xubicheng/advanced-desktop/hardware/README.md

# hardware/ — 外壳、转接板、装配图

```
hardware/
├─ enclosure/        外壳：FreeCAD 参数化模型 + OpenSCAD 备选 + 打印参数
├─ adapter-board/    载板/转接板：KiCad 工程（电源保护 + Hub 供电 + 排针 + 按键）
└─ assembly/         装配图、爆炸图、螺丝与走线表
```

## 状态

- `adapter-board/`：**Carrier-Lite v0.1 草案已出板**（60×45mm，2 层），含 Gerber、BOM、坐标、STEP、预览与制板说明，见 [FAB-NOTES.md](adapter-board/FAB-NOTES.md)。未出原理图，尺寸待实测。
- `enclosure/`、`assembly/`：**仍为空骨架。** 设计参数已定，图纸尚未出。

## 已定的关键参数（照此建模）

| 项 | 值 | 出处 |
|---|---|---|
| 外形 | **132 × 76 × 40 mm** | v3 §3.1 |
| 内部净高 | ≥ 24 mm（RJ45 13.5mm 为最高元件） | v3 §3.1 |
| 主板 | BeagleBone Black，86.36 × 53.34 × 1.6 mm | 官方 |
| 壁厚 | 2.4–3.0 mm | v3 §6.2 |
| 材质 | **ABS**（主体）+ **5052 铝 1.5mm**（底盖兼配重） | v3 §6.2 |
| 开孔率 | 总 3.3–3.6%（侧面进风 φ2×6×2，底部后段出风 φ2×12） | v3 §6.3 |
| 顶面 | **不开孔**（手感 / 进灰 / 烫手） | v3 §6.3 |
| 散热片 | 铝 20×20×8 + 导热垫 1.0mm ≥3W/mK | v3 §6.4 |
| 光学高度 | 按实测的鼠标模块定，配 0.5/1.0/1.5mm 三档垫片 | v3 §4.4 |

## 许可

**CERN-OHL-S-2.0**（强互惠）。改过的设计必须以同一许可公开。
