xubicheng/advanced-desktop/logs/2026-11-06-v1-to-v4.md

# 对话纪要（脱敏）· 2026-11-06 · v1 → v4

> 本文是需求与决策的**留痕**，不含任何凭证、联系方式、账号信息。
> 详细技术判断见 `docs/CHANGELOG.md`。

---

## 第一轮（v1）：可落地的完整设计方案

**需求要点**
- 产品：鼠标形态的无屏微型计算机；板载麦克风与扬声器；无屏；HDMI 外接；自身位移驱动光标；Linux；开源硬件；MIT。
- 明确排除树莓派。
- 元器件需在南京金盛 / 华龙可买。
- **不要实际下单、不要联网采购、不要动任何现有站点。**
- 要求逐条回答 12 个工程问题（主控、显示接口、光标、光学、音频、AI 链路、OS 与授权、供电、BOM、MVP、验收、风险合规）。
- 诚实优先，型号/封装/数量必须具体，不写营销话术。

**产出**：v1 方案（H618 / Orange Pi Zero 3 路线），BOM ≈ ¥320 / 降本 ¥169。

**结论**：路线可行，但板级不开源（只有原理图 PDF，无 Gerber），与「全开源硬件」冲突。

---

## 第二轮（v2）：开源硬件成为硬门槛

**需求要点**
- 「全开源硬件」是硬门槛，成本可高、性能可弱；H618 / Orange Pi 作废。
- 讲清 L0–L3 分层，给 2–3 个真 L1 候选，明确首选与性能代价；做不到 L0 要直说。
- 软件：一套核心 + Linux/Android 双端；Android 息屏可用。
- 逐项许可证清单，不得笼统说「都是 MIT」（点名 FFmpeg 双轨、Android TTS/ASR 闭源、Kotlin/Compose、Flutter）。
- 取消电池，改 USB-C 5V/3A。
- 手工组装友好：2.54 排针 / 凤凰端子 / JST-XH，禁 0.5mm FPC 与 BGA；说明哪些委外、哪些自焊。
- 散热从外壳设计解决，目标满载 30 分钟 ≤45°C，两级后备。
- 光学买芯片 + 透镜配套件；P0 用整块 USB 鼠标模块兜底。
- 线上 / 线下两张采购清单。
- 尝试读取一个飞书参考链接，取不到要如实说明。
- 版本化目录 + CHANGELOG + README。

**产出**：v2 方案（L0–L3、BeaglePlay 首选 / BBB 备选 / Milk-V Mars 判 L1.5）+ MVP 清单 + CHANGELOG + README。

**关键判断**：L1 + 真鼠标形态 + 1080p **只能取二**。
**如实说明**：飞书链接取不到（需登录，返回登录页图片），未采纳、未编造。

---

## 第三轮（v3）：决策闭环

**用户拍板**
- D1 = β BeagleBone Black（L1，720p，单核 1GHz，¥550 级）；
- D2 = 坚持真鼠标形态，不做掌托式；
- D3 = 直接内嵌成品 USB 鼠标模块，不做 PMW3389 自研（光学腔问题消失）；
- D4 = 先 Android，再 Linux 硬件端，但目标平台要覆盖 Windows 10+ 与 Linux；
- D5 = 严格宽松许可（只允许 Apache/MIT/BSD），**不把 GPL 库链接进核心，允许 GPL 工具以独立进程 / CLI 调用**。

**其他要求**
- 逐条算清 β 的六项工程连带代价（外壳尺寸、USB Hub、720p、单核性能、micro-HDMI 与供电、断供降级链），不许回避。
- 采购淘宝优先；线下只买通用件；给总预算。
- 建 public 仓库，三许可分层，先加 `.gitignore` 再首次提交，纪要脱敏。
- 里程碑汇报：Android 最小链路成型先报一次；仓库推送成功立刻报。
- 诚实优先，不得编造型号/价格/供货/性能/许可证。

**产出**：v3 方案 + Android 先行周计划 + 许可清单 + 采购清单 + DECISIONS + CHANGELOG。

**关键结论（都是硬事实）**
- 外壳下限 **132×76×40mm**，重 **250–300g**（常规重鼠的 2 倍）；
- 单核 1GHz 上 whisper tiny 慢 5–10 倍 → **本地 STT/TTS 判死**，只留预录提示音；
- 供电必须 **DC 5V/4A**，峰值 2.76A，入口 ≥4.90V；
- BBB 断供的 L1 降级链：BBB → BBB Wireless → BeagleBone Green → BeaglePlay（破形态）→ 暂停，**不退回专有板**。

---

## 第四轮（v4）：概念模型修正

**用户澄清**（推翻 v3 的理解）
- 不是「AD 要做 Android 版 + Windows 桌面版 + Linux 桌面版」三套软件；
- 而是：**AD 本体的画面要能投到 Windows 10/11 与 Linux 桌面的显示器上**；
- AD 是那台无屏计算机，**显示器是别人的**；手机是 AD 的一种载体，屏幕可以息屏。

**用户给出的三条投屏路线**（要我给取舍而非罗列）
1. 自渲染 + 自有 Receiver（MJPEG over TCP）——倾向做 MVP；
2. scrcpy 路线（Apache-2.0）——做兜底；
3. WebRTC / 硬件 H.264——功能强但有许可与体积问题。

**我的取舍**
- **首选方案 1**：只有它能做到「AD 自己的画面」而不是「镜像整块手机」；只有它在息屏时天然成立；许可全宽松；体积最小；且 AD 的 UI 是状态驱动、帧率需求低，MJPEG 的带宽劣势几乎不存在。
- **方案 2 做兜底**，触发条件写死（需要 >20fps 或要看手机原生界面）。
- **方案 3 留架构位**（三个 trait：FrameSource / FrameEncoder / FrameTransport），给出 4 个升级切换点。

**技术纠偏**
- 用户建议「Android 自带 YuvImage/JPEG 编码」——方向对、API 错：`YuvImage` 吃 NV21，是给相机用的；我们自渲染的产物在 `Bitmap` 里，应该用 `Bitmap.compress(JPEG, q, out)`。

**反向输入**
- USB 鼠标模块（OTG）→ 读 HID 端点 → `PointerEvent` → TCP 上行 → Windows `SendInput` / Linux `/dev/uinput`。
- 与 BBB 端**共用同一份事件结构体**，只是注入后端不同。
- 「AD 当别人的鼠标」这条链路天然成立。

**如实说明的边界**
- Windows 的 UAC 提权窗口、锁屏、安全桌面**收不到 SendInput**——这是系统安全边界，不是 bug；
- Linux 的 `/dev/uinput` 需要 `input` 组或 udev 规则，**不是开箱即用**；
- Android 的 USB 设备授权每次插拔可能弹框；
- 息屏后厂商 ROM 可能限流，帧率会掉，需实测。

**产出**：v4 方案（概念模型、投屏三方案取舍、Mermaid 数据流图、反向输入、息屏实测计划 T1–T6、兼容基线、能力差异表、新增风险 7 条）+ CHANGELOG v4.0。

---

## 贯穿四轮的约束（一次都没破）

1. **不下单、不采购、不动任何现有站点**；
2. **诚实优先**：不确定就标「需询价 / 需实测 / 需核实」，不编造型号、价格、许可证；
3. **不为了好看淡化硬事实**（单核跑不动本地模型、鼠标 250–300g、720p 上限）；
4. **参考资料不等于正确**：豆包方案被逐条对照，采纳 4 点、冲突 5 点、错误 5 点。
