xubicheng/advanced-desktop/docs/README.md

# AD 项目文档索引

AD（Advanced Desktop）= **鼠标形态的无屏微型计算机**。板载麦克风与扬声器，语音进、语音出；自身位移驱动光标。**屏幕是可选外设**：要么 BBB 原生 HDMI 直出，要么由 Android 载体把 AD 自己的画面投到 PC 显示器上。硬件走 L1 开源路线（BeagleBone Black），软件是一份 Rust 核心 + 两个渲染器 + 一个 PC 端 Receiver。

> 当前版本：**v4.0**（2026-11-06）
> 状态：决策已闭环（D1–D5），概念模型已修正（AD ≠ 桌面软件）。**未采购、未下单、未改动任何站点。**

---

## 文档清单

| 文档 | 一句话说明 | 版本 | 路径 |
|---|---|---|---|
| **设计方案 v4（当前有效）** | 概念模型修正 + 投屏链路。AD 是本体，屏幕是外设；Windows/Linux 端只是 Receiver（显示帧 + 注入指针） | v4.0 | [v4/AD-鼠标形无屏微型计算机-设计方案-v4.md](./v4/AD-鼠标形无屏微型计算机-设计方案-v4.md) |
| **设计方案 v3（硬件与许可基线）** | β 路线定稿：六项工程连带代价、720p、USB Hub、供电、散热重算、V1–V14 验收、R1–R12 风险。**v4 沿用其 D1/D2/D3/D5、散热、BOM、采购** | v3.0 | [v3/AD-鼠标形无屏微型计算机-设计方案-v3.md](./v3/AD-鼠标形无屏微型计算机-设计方案-v3.md) |
| **Android 先行周计划** | 执行件。2 周排期、W1/W2 共 15 条验收线、代码结构、三族平台兼容基线 | v3.0 | [v3/Android-先行-周计划.md](./v3/Android-先行-周计划.md) |
| **许可清单** | 组件 / 版本 / 许可证 / 是否链接进核心 / GPL 隔离方式 / 风险等级；含模型权重逐项核实状态 | v3.0 | [v3/许可清单.md](./v3/许可清单.md) |
| **采购清单（淘宝优先）** | 表 A 淘宝（关键路径 / 可延后，含搜索关键词）、表 B 线下金盛/华龙、总预算三档 | v3.0 | [v3/采购清单-淘宝优先.md](./v3/采购清单-淘宝优先.md) |
| **决策记录** | D1–D5 已拍板项 + C1 平台范围澄清 + O1–O6 未关闭项 + 历史失效决策 | v3.0 | [DECISIONS.md](./DECISIONS.md) |
| **变更记录** | v1→v2→v3 全部变更，按「变更点 / 原因 / 影响」三列；v3 含参考材料对照（采纳/冲突/错误） | v3.0 | [CHANGELOG.md](./CHANGELOG.md) |
| **MVP 手工样品实施清单** | 执行件。买料、S0–S10 分步装配、每步可测通过标准、上电检查、故障排查 | v2.1（β 路线） | [MVP-checklist/MVP-手工样品实施清单.md](./MVP-checklist/MVP-手工样品实施清单.md) |
| 设计方案 v2（已被 v3 取代） | BeaglePlay 首选 + 掌托式 + 自研光学。保留供追溯 | v2.0 | [v2/AD-鼠标形无屏微型计算机-设计方案-v2.md](./v2/AD-鼠标形无屏微型计算机-设计方案-v2.md) |
| 设计方案 v1（已作废） | H618 路线，板级不开源，保留不删 | v1.0 | [v1/AD-鼠标形无屏微型计算机-设计方案-v1.md](./v1/AD-鼠标形无屏微型计算机-设计方案-v1.md) |

---

## 快速导航

| 你想知道 | 去看 |
|---|---|
| **AD 到底是什么**（是不是要做三套软件） | **v4 §1 概念模型**（答案：不是。AD 是本体，屏幕是外设） |
| 投屏用哪个方案、为什么不用 scrcpy | v4 §2（三方案对比 + 取舍 + 升级切换点） |
| 投屏数据怎么流 | v4 §3（Mermaid 图：路 A / 路 B） |
| AD 怎么驱动 PC 的光标 | v4 §4（OTG HID → PointerEvent → SendInput / uinput） |
| 手机息屏还能投吗 | v4 §5（能，且这是首选方案的关键优势）+ T1–T6 实测计划 |
| 支持 Windows/Linux 哪些版本 | v4 §6（Win10 1809+；glibc ≥2.28；**不支持 CentOS 7/8**） |
| 这东西到底能不能做、要妥协什么 | v3 §0 一句话结论 + §3 六项连带代价 |
| 为什么选 BBB，为什么只有 720p | v3 §3.3 + [DECISIONS.md](./DECISIONS.md) D1 |
| 外壳多大、多重、怎么握 | v3 §3.1（132×76×40mm，250–300g，掌心抓握） |
| USB 三件怎么共存、会不会烧板 | v3 §3.2（自供电 Hub + 切断上游 VBUS） |
| 单核能不能跑本地语音 | v3 §3.4（**不能**，已判死） |
| BBB 买不到怎么办 | v3 §3.6（T0–T4 降级链，不退回专有板） |
| 散热会不会烫手 | v3 §6（ABS + 侧进底出 + 锁频 800MHz） |
| 买什么、多少钱 | [v3/采购清单-淘宝优先.md](./v3/采购清单-淘宝优先.md) |
| 许可证有没有坑 | [v3/许可清单.md](./v3/许可清单.md)（重点看 piper→espeak-ng 与模型权重） |
| 排期 | [v3/Android-先行-周计划.md](./v3/Android-先行-周计划.md) + v4 §8（W3 投屏 / W4 反向指针） |
| 之前为什么推翻 H618 / BeaglePlay / 三套软件 | [CHANGELOG.md](./CHANGELOG.md) 的「已推翻」表 |

---

## 版本规则

1. **不覆盖旧版本**：每次大改新建目录（v4…），旧版原样保留。
2. **每次改动必须进 CHANGELOG**：按「变更点 / 原因 / 影响」三列，不接受无记录的修改。
3. **改设计前先改 DECISIONS**：决策记录是上游，设计文档是下游。
4. **不确定项一律标注**：`【实测】` `【询价】` `【需核实】`，禁止估造。

---

## 目录结构

```
docs/
├─ README.md                                   ← 本文件（索引）
├─ CHANGELOG.md                                ← 变更记录
├─ DECISIONS.md                                ← 决策记录（D1–D5 / C1 / O1–O6）
├─ v1/
│  └─ AD-鼠标形无屏微型计算机-设计方案-v1.md      ← 已作废，存档
├─ v2/
│  └─ AD-鼠标形无屏微型计算机-设计方案-v2.md      ← 已被 v3 取代，存档
├─ v3/
│  ├─ AD-鼠标形无屏微型计算机-设计方案-v3.md      ← 硬件与许可基线（部分被 v4 取代）
│  ├─ Android-先行-周计划.md
│  ├─ 许可清单.md
│  └─ 采购清单-淘宝优先.md
├─ v4/
│  └─ AD-鼠标形无屏微型计算机-设计方案-v4.md      ← 当前有效（投屏链路）
└─ MVP-checklist/
   └─ MVP-手工样品实施清单.md                    ← 执行件
```

---

## 外部参考

| 来源 | 状态 |
|---|---|
| `https://feishu.doubao.com/drive/file/DJfTbpN2Doubgvx4VfTctA9snmg`（v2 阶段用户提供） | ❌ **取不到**（需登录，返回登录页）。未采纳其内容，未编造 |
| `D:\原有的下载2026.2\AD设计方案_v2.md`（v3 阶段用户提供的本地文件，豆包生成） | ✅ 已读取 163 行，逐条对照见 [CHANGELOG v3.0 §3.2](./CHANGELOG.md)。采纳 4 点、冲突 5 点、错误 5 点 |
| BeagleBone Black 官方文档 `beagleboard.org/board/beaglebone-black` | ✅ 已核实（尺寸 86.36×53.34mm、AM3358、512MB、micro-HDMI、1×USB-A host） |
| BeaglePlay 官方文档 `docs.beagleboard.org` | ✅ 已核实（v2 阶段） |
| Milk-V Mars 官方文档 `milkv.io` | ✅ 已核实（v2 阶段，判 L1.5） |
| 许可核实：sherpa-onnx / SenseVoice / whisper.cpp / FunASR / VITS / piper / espeak-ng | ✅ 2026-11-06 抓取 LICENSE 原文，详见 [许可清单](./v3/许可清单.md) |
