xubicheng/advanced-desktop/hardware/adapter-board/preview-bottom.png

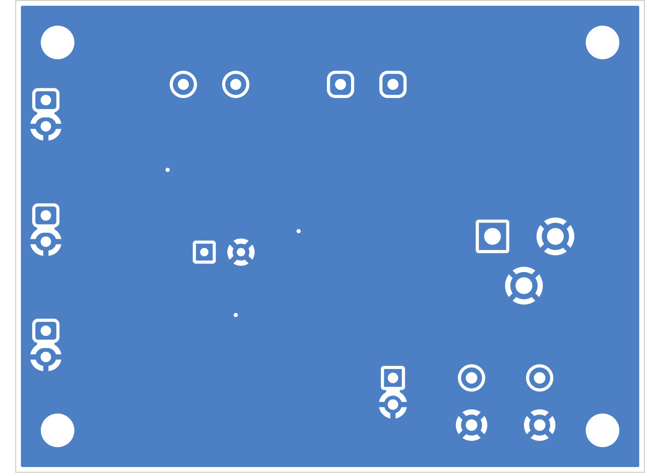
hardware/adapter-board/preview-bottom.png
