xubicheng/advanced-desktop/hardware/adapter-board/preview-top.png

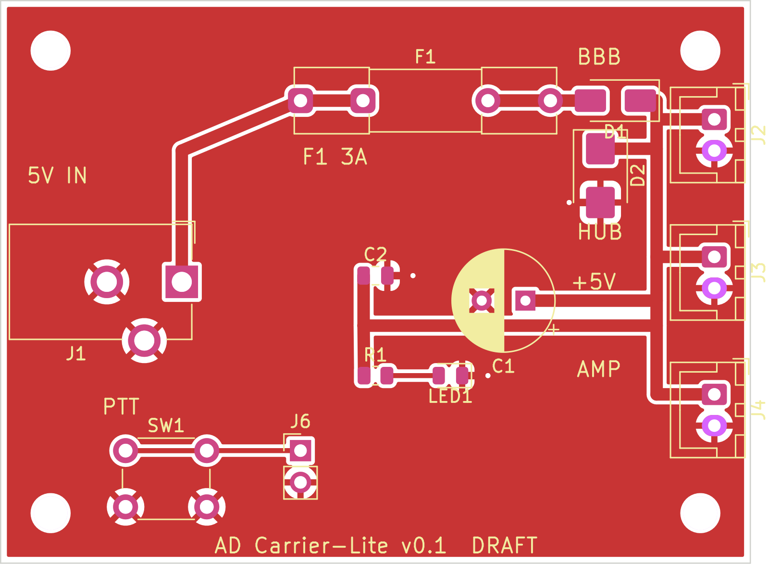
hardware/adapter-board/preview-top.png
