xubicheng/advanced-desktop/bom/README.md

# bom/ — 采购清单

| 文件 | 内容 |
|---|---|
| [BOM-taobao.csv](BOM-taobao.csv) | 表 A：淘宝采购单（关键路径 / 可延后 / 工具 / 耗材） |
| [BOM-offline.csv](BOM-offline.csv) | 表 B：南京金盛 / 华龙线下采购单（含摊位类型） |

## 预算档位

| 口径 | 金额 |
|---|---|
| 最低可行（全自打印、工具已有） | **≈ ¥690** |
| 典型（工具全买、外发打印） | **≈ ¥1,600** |
| 舒适（含全部可选与备用件） | **≈ ¥2,100** |

## 说明

- 所有价格为**区间估算**，不是报价；标注「需询价」的品类波动大；
- **未下单、未询价、未访问任何购物站点**；
- 不提供店铺链接（易失效，且不做背书）；
- 详细理由与避坑见 [docs/v3/采购清单-淘宝优先.md](../docs/v3/采购清单-淘宝优先.md)。
