xubicheng/advanced-desktop/docs/MVP-checklist/MVP-手工样品实施清单.md

# AD MVP 手工样品 · 实施清单

> 配套文档：`docs/v3/AD-鼠标形无屏微型计算机-设计方案-v3.md`（v3.0）
> 适用路线：**β = BeagleBone Black（唯一路线）**。α/γ 已作废。
> 本清单是"照着做"的执行件：**买料 → 焊 → 装 → 测 → 过**。每一步都有可测量的通过标准。
> 状态：**未采购、未下单**。所有价格为区间【询价】，所有性能为预期值【实测】。
>
> **v3 关键差异（照做前必读）：**
> 1. 分辨率 **720p**（不是 1080p）；
> 2. 供电 **DC 5.5×2.1 / 5V 4A**（不是 USB-C 5V/3A）；
> 3. 光标 **只用成品 USB 鼠标模块**，**取消 PMW3389 自研**（原 S5 整节删除）；
> 4. 外壳 **132×76×40mm 真鼠标**（不是 160×95×100 掌托式）；
> 5. 新增 **4 口自供电 USB Hub + 上游 VBUS 断路**；
> 6. 本地 STT/TTS **不做**，语音默认走云端。

---

## 0. 总览

| 阶段 | 内容 | 预计工时 | 卡点 |
|---|---|---|---|
| S0 | 备料与工具 | 2h | 等到货、**BBB 供货** |
| S1 | 裸板点亮（micro-HDMI @720p） | 4h | **不过则换板，不恋战** |
| S2 | 网络 + 输入 | 2h | BBB 无板载 WiFi |
| S3 | 音频链路 | 6h | 底噪/啸叫 |
| S4 | 光标（内嵌成品 USB 鼠标模块） | 3h | **光学高度适配** |
| S5 | ~~光标自研（PMW3389）~~ | — | **v3 已删除** |
| S6 | 集成分线（电源保护 + Hub + VBUS 断路） | 8h | 焊接、反灌 |
| S7 | 结构装配（132×76×40） | 10h | 干涉、打印公差 |
| S8 | 热测与散热整改 | 6h | **第二大不确定** |
| S9 | 语音链路（云端） | 10h | 延迟 |
| S10 | 长跑与验收 | 8h | — |
| **合计** | — | **≈59h** | — |

**原则：S1 不过不许往下走；S4 若光学高度无法适配（换 2 个模块仍失败）→ 改为「外置 USB 鼠标过渡」，不得停摆；S8 超标按两级后备整改。**

---

## 1. S0 备料与工具

### 1.1 采购清单（按"关键路径"排序）

#### A. 线上（淘宝/阿里系，先下这几单，等 2–4 天）

| 序 | 名称 | 型号/规格 | 数量 | 单价区间 | 关键路径 | 备注/替代 |
|---|---|---|---|---|---|---|
| A1 | 主控板 | **BeagleBone Black Rev C**（AM3358/512MB/4GB eMMC） | 1 | ¥400–520【询价】 | ★★★ | 买不到 → BBB Wireless（T1）；再不行看 v3 §3.6 |
| A2 | 光标模块 | **成品 USB 鼠标模块 + 光学透镜**（非 PMW3389 自研） | 2 | ¥25–60 | ★★★ | **买两个不同型号**；不要买成无线接收器 |
| A3 | USB 声卡模块 | CM108 / SSS1629（**mic in** + 3.5mm out） | 2 | ¥15–35 | ★★★ | 必须带麦克风输入 |
| A4 | USB Hub 模块 | 4 口 USB2.0，**自供电、带 5V 外供焊盘** | 1 | ¥15–30 | ★★★ | FE1.1s；GL850G 备选 |
| A5 | USB WiFi | RTL8188EU / 8192EU，**带外置天线** | 1 | ¥20–40 | ★★★ | BBB 无板载 WiFi |
| A6 | micro-SD（可选） | 32GB A1（SanDisk） | 1 | ¥20 | ★ | BBB 可从 eMMC 启动，SD 作救砖 |
| A7 | 散热片 | 铝 20×20×8 | 2 | ¥2–5 | ★ | 壳内空间紧，不要超过 8mm |
| A8 | 导热垫 | 1.0mm，≥3W/mK | 2 | ¥5–15 | ★ | 另备 0.5mm |
| A9 | 杜邦线 / XH2.54 | 20cm 套装 | 1 套 | ¥10–20 | ★ | — |
| A10 | 铜柱螺丝 | M2.5 套装 | 1 套 | ¥15–25 | ★ | **下单前量 BBB 安装孔** |
| A11 | **micro-HDMI 转接** | micro-HDMI 公 → HDMI 母 **软排线** 20cm | 1 | ¥20–40 | ★★★ | **不要硬转接头**（会拽掉座子） |
| A12 | 铝板 | 5052，1.5mm，150×200 | 1 | ¥20–40 | 否 | 底盖兼配重 |
| A13 | 5V 电源 | **5V/4A**，DC 5.5×2.1 | 1 | ¥25–45 | ★★★ | **不能买 5V/3A**；须实测 ≥4.90V |
| A14 | 保险丝 | 3A 慢断 + 5×20 座 | 1 套 | ¥5–10 | ★★★ | **不要用 1.1A 自恢复** |
| A15 | TVS + 肖特基 | SMAJ5.0A ×4，SS54 ×2 | 1 套 | ¥5–8 | ★★ | 过压 + 防反接 |

#### B. 线下（南京金盛 / 华龙电子城）

| 序 | 名称 | 规格 | 数量 | 单价 | 备注 |
|---|---|---|---|---|---|
| B1 | 喇叭 | 40mm 8Ω 2W，带腔体 | 2 | ¥4–12 | 挑两只一致性好的 |
| B2 | 驻极体麦克风模块 | MAX9814 / MAX4466（带 AGC） | 2 | ¥8–20 | 裸驻极体电平太低 |
| B3 | PAM8403 功放板 | 3W，带滤波 | 2 | ¥5–10 | 成品板 |
| B4 | 轻触开关 | 6×6×5 / 12×12 直插 | 10 | ¥0.2–1 | PTT 用大行程 |
| B5 | 拨动开关 | 2 档 3 脚 | 2 | ¥1–3 | 预留总电源 |
| B6 | 洞洞板 | 5×7cm、7×9cm | 各 2 | ¥3–6 | — |
| B7 | 排针/排母 | 2.54 单排 | 各 5 | ¥0.5 | — |
| B8 | JST-XH 端子 | 2P/3P/4P 带线 | 各 5 | ¥1 | 比杜邦线牢 |
| B9 | 电源适配器 | **5V/4A，DC 5.5×2.1** | 2 | ¥30–50 | **现场要求实测输出电压** |
| B10 | DC 座/插头 | 5.5×2.1 | 各 2 | ¥1–5 | — |
| B11 | 电解电容 | 470µF/10V 低 ESR | 5 | ¥0.5 | 电源入口储能 |
| B12 | 磁珠 | 600Ω@100MHz 3A | 5 | ¥0.3 | — |
| B13 | 电阻电容套装 | 0805 常用值 | 1 套 | ¥15 | — |
| B14 | 热缩管/双面胶/扎带 | — | 1 套 | ¥15 | 绝缘固定 |
| B15 | 螺丝/脚贴 | M2.5 + PTFE 脚贴 | 1 套 | ¥15 | 脚贴影响光学高度 |
| B16 | 防尘网 | 80 目尼龙网 | 1 | ¥5–10 | 侧进风口 |

#### C. 工具（若无则补）

| 工具 | 规格 | 必需度 |
|---|---|---|
| 恒温焊台 | 60W，可调 300–350°C | ★★★ |
| 焊锡 | 0.6mm 有铅/无铅 + 助焊剂 | ★★★ |
| 数字万用表 | 带通断/二极管档 | ★★★ |
| USB 电压电流表 | 支持 PD 诱骗更好 | ★★★ |
| 红外测温枪 | −50~380°C | ★★ |
| 游标卡尺 | 0.02mm | ★★ |
| 塞尺 | 0.05–1.0mm | ★★（光学高度） |
| 剥线钳/斜口钳/镊子 | — | ★★ |
| 3D 打印机或外协 | **ABS**（不要 PETG/PLA） | ★★ |

> **★★★ = 缺一件就开不了工。**

### 1.2 到货验收

| 检查 | 方法 | 通过标准 |
|---|---|---|
| 主控板外观 | 目视 | 无磕碰、屏蔽罩无变形、连接器无歪 |
| 主板短路 | 万用表二极管档量 5V↔GND | >1kΩ（<10Ω 立即退货） |
| microSD | 读卡器测容量/速度 | 实测 ≥标称 90% |
| 鼠标模块 | 插电脑当鼠标用 | 光标能动、左右键正常、无丢帧 |
| 声卡模块 | 插电脑听回放 | 无爆音、麦克风能录 |
| 喇叭 | 万用表量阻抗 | 6.5–8.5Ω |

---

## 2. S1 裸板点亮（4h）—— **全项目生死线**

| 步 | 操作 | 工时 | 通过标准 |
|---|---|---|---|
| S1.1 | 下载 **BeagleBoard 官方 Debian 镜像**，用 balenaEtcher 烧到 microSD（或直接烧 eMMC） | 0.5h | 烧写完成无报错 |
| S1.2 | 只接：**DC 5.5×2.1 5V/4A 电源** + **micro-HDMI 软排线 → 显示器** + SD 卡 | 0.5h | 板载 4 个用户灯按官方启动序列闪烁 |
| S1.3 | 用 USB-TTL 接调试串口（P9 的 UART0：GND/TX/RX），看启动日志 | 1.0h | 串口能打印到 `login:` |
| S1.4 | 等待首次启动（1–3 分钟） | 0.5h | **屏幕出现桌面 / 或串口可登录** |
| S1.5 | 设分辨率 1280×720（`xrandr --output HDMI-1 --mode 1280x720` 或 `wlr-randr`） | 0.5h | 显示 1280x720 |
| S1.6 | 连续播放 720p 视频 30 分钟 | 1.0h | **无闪屏、无花屏、无重启、无欠压告警**（`dmesg` 中查 voltage 关键字） |

**判定与止损：**
- ✅ 通过 → 进 S2。
- ❌ 无显示 → 先分三步排查：① 串口有没有启动日志（有 = 板活着，是显示问题）；② 换 micro-HDMI 转接、换显示器；③ 换镜像。3 次仍失败 → **换板**，不要试图改内核。
- ❌ 反复重启 → **90% 是电源**：先量 DC 座入口电压（≥4.90V），再查线径（≤1m、≥20AWG），最后才怀疑板。
- ❌ 串口全无输出 → 检查 USB-TTL 的 TX/RX 是否交叉、GND 是否共地。

> BBB 的 micro-HDMI 座是贴片焊，**插拔时务必扶住板子**；建议转接线一次插好就不再动。

---

## 3. S2 网络 + 输入（2h）

| 步 | 操作 | 工时 | 通过标准 |
|---|---|---|---|
| S2.1 | 先接网线（RJ45）确认联网，再插 USB WiFi 模块 | 0.5h | `ping 223.5.5.5` 通；`iwconfig` 能看到 wlan0 |
| S2.2 | 配 WiFi（`nmcli` 或 `wpa_supplicant`） | 0.5h | 拔掉网线后仍能上网 |
| S2.3 | `apt update && apt upgrade` | 0.5h | 无错误 |
| S2.4 | 插 USB 键盘 + 鼠标，开 SSH | 0.5h | 另一台电脑可 `ssh debian@<ip>` 登录 |

> BBB 无板载 WiFi。**USB WiFi 的天线必须能引出到外壳外部**，否则装在壳里信号会掉一档。

---

## 4. S3 音频链路（6h）

| 步 | 操作 | 工时 | 通过标准 |
|---|---|---|---|
| S3.1 | USB 声卡插上，`arecord -l` / `aplay -l` 能看到设备 | 0.5h | 列出 card/device |
| S3.2 | 麦克风焊到声卡 mic 输入（屏蔽线，<3cm） | 1.5h | `arecord -f S16_LE -r 16000 -c 1 t.wav` 能录到声音 |
| S3.3 | `aplay` 回放录音 | 0.5h | 清晰人声，无爆音/电流声 |
| S3.4 | PAM8403 + 喇叭接线，独立 5V 供电 | 1.0h | 播放音乐有声 |
| S3.5 | 最大音量测响度 | 1.0h | 0.3m 处 **≥75dB SPL**，无破音 |
| S3.6 | 麦克风 + 喇叭同处一盒，测啸叫 | 1.0h | 最大音量**无自激** |
| S3.7 | 底噪测量 | 0.5h | 静音录 10s，RMS **<−60dBFS** |

**常见问题：**
| 现象 | 原因 | 处理 |
|---|---|---|
| 录音全是电流声 | 麦克风线太长/无屏蔽 | 换屏蔽线，缩短到 3cm |
| 音量一大就破音 | 喇叭后腔没做/功放增益过高 | 先做临时后腔（纸盒密封），增益调到 70% |
| 说话时喇叭啸叫 | 麦克风与喇叭同腔 | 物理隔开，麦克风朝上、喇叭朝下 |
| `arecord` 录到静音 | mic bias 未开/接错脚 | 用声卡模块自带的 mic 输入，不要接 line-in |

---

## 5. S4 光标：内嵌成品 USB 鼠标模块（3h）

> v3 的 D3 决策：**不再自研 PMW3389 + 透镜 + 光学腔**。直接买成品 USB 鼠标模块（USB HID），插上就是鼠标。
> 原来的 S5「光标自研」整节删除；不确定性从「写驱动 + 调光学腔」变成「选模块 + 配光学高度」。

| 步 | 操作 | 工时 | 通过标准 |
|---|---|---|---|
| S4.1 | 模块插电脑验证 | 0.5h | 光标能动、左右键/滚轮正常、无丢帧 |
| S4.2 | 模块插 BBB 的 USB 口（此时还没接 Hub） | 0.5h | `lsusb` 能看到；`cat /dev/input/mouse0` 有输出 |
| S4.3 | 量 **透镜下沿到桌面的距离** | 0.5h | 记录实测值（不同模块 1.2–2.0mm 不等）【实测】 |
| S4.4 | 用 3D 打印的三种厚度垫片（0.5 / 1.0 / 1.5mm）试装，找到光标最稳的一档 | 1.0h | 慢移不飘、快移不丢、静止不漂 |
| S4.5 | 用 `xinput` 调加速度与速度（若 DPI 偏高） | 0.5h | 1080p 屏幕上从左上到右下约 3–4 次滑动 |

**熔断规则：**
> 若换 2 个不同型号的模块仍无法让光标稳定移动（飘 / 丢帧 / 完全不响应）→ **不要继续折腾**，改为「外置 USB 鼠标」过渡，把内嵌留到结构版再解决。项目不得因此停摆。

**常见问题：**
| 现象 | 原因 | 处理 |
|---|---|---|
| 光标完全不动 | 模块光学高度太高（透镜离桌面太远） | 减薄垫片，让透镜贴近桌面 |
| 慢移正常快移飘 | 光学高度偏低 / 桌面太光滑 | 加 0.5mm 垫片；换鼠标垫测试 |
| 静止时缓慢漂移 | 桌面反光 / 漏光 | 换哑光鼠标垫；模块四周遮光 |
| 光标「飞」得太快 | DPI 过高（1600+） | 用 `xinput --set-prop` 降加速度，或换 800/1000 DPI 模块 |
| 左右键没反应 | 买成了「只有传感器没有按键」的模块 | 换带完整按键的模块 |

---

## 6. S5（已删除）

原 S5「光标自研（PMW3389 + 光学腔）」在 v3 中被 D3 决策取消，**整节作废**。留此标题只为让旧版读者知道「这里少了一节」，不是遗漏。

---

## 7. S6 集成分线（8h，可选但推荐）

> 目的：把「DC 输入保护 + USB Hub 自供电路 + 排针 + 按键」做在一块洞洞板上，替代一堆飞线。
> 元件数控制 **≤25 个**，全部 0805/插件，纯手焊。

| 步 | 操作 | 工时 | 通过标准 |
|---|---|---|---|
| S6.1 | 洞洞板布局（先画纸上草图） | 1.0h | 元件不重叠，走线最短；**Hub 远离麦克风** |
| S6.2 | 焊 DC 5.5×2.1 座 → 3A 保险丝 → SS54（防反接）→ SMAJ5.0A → 470µF + 100nF | 2.0h | 空载输出 5.0±0.1V；**反接测试不烧**（用限流电源试） |
| S6.3 | 焊 Hub 的 5V 外供线（从系统 5V 母线取） | 1.0h | Hub 4 口供电正常，单口带载 0.5A 不掉压 |
| S6.4 | **切断 Hub 上游线的 VBUS（红线）与 ID，只留 D+/D−/GND**，断口热缩绝缘 | 1.0h | 万用表量上游 VBUS 与 Hub 5V **不导通**（>1MΩ） |
| S6.5 | 焊排针引出 5V / GND / PTT GPIO（P9 的 GPIO 口） | 1.0h | 万用表通断全通 |
| S6.6 | 焊 PTT 轻触 + 音量键 + 指示灯（各串 1kΩ 限流） | 1.0h | 按下导通、松开断开 |
| S6.7 | **上电前检查**：5V↔GND | 0.5h | **>1kΩ** |
| S6.8 | 反灌验证（V5 验收） | 0.5h | 只给 Hub 供电、不给 BBB 供电时，BBB **不得出现半上电**（指示灯不亮、串口无输出） |

### 上电检查点（每次通电前必做，5 步）

1. **目视**：无连锡、无歪件、无金属屑；
2. **通断**：二极管档量 5V↔GND，**>1kΩ**；
3. **极性**：电解电容负极、二极管方向、**DC 座中心正**；
4. **限流上电**：可调电源限流 500mA，看电流是否异常（>300mA 空载即有短路）；
5. **全电流上电**：确认正常后接主板。

---

## 8. S7 结构装配（10h）

| 步 | 操作 | 工时 | 通过标准 |
|---|---|---|---|
| S7.1 | 泡沫/纸板做 1:1 内腔模型（**132×76×40**），试装板+Hub+喇叭+散热片 | 2.0h | 全部就位，能盖上；**内部净高 ≥24mm** |
| S7.2 | FreeCAD 参数化建模（长/宽/高/壁厚/接口位置 5 个变量） | 3.0h | 导出 STEP/STL 无破面 |
| S7.3 | 打印（**ABS**，0.2mm 层高，30% 填充，3 壁） | 2.0h | 尺寸误差 ≤0.3mm；**先打半壳试装** |
| S7.4 | 装铜柱、固定主板、贴导热垫 + 20×20×8 散热片 | 1.0h | 主板不晃，散热片贴合 |
| S7.5 | 装喇叭 + 密封音腔（3mm EVA 围边） | 1.0h | 后腔密封（吹气不漏） |
| S7.6 | 装鼠标模块 + **三档垫片校准光学高度** | 0.5h | 光标不飘、不丢帧 |
| S7.7 | 侧进风 / 底出风开孔 + 80 目防尘网 + 尾部接口应力消除 | 1.0h | 总开孔率 3.3–3.6%；孔边倒角 0.5mm 无毛刺 |
| S7.8 | 走线、扎带、绝缘垫、脚贴、称重记录 | 0.5h | 无线材被夹；**实测重量记入验收表** |

**装配顺序（不可颠倒）：**
```
下壳（含铝底板） → 鼠标模块 + 光学垫片 → 喇叭+音腔 → Hub 与电源小板 → 主板+散热片 → 麦克风 → PTT 按键 → 上盖 → 脚贴 → 称重
```

**固定与绝缘规范：**
| 项 | 做法 |
|---|---|
| 承重 | **只能用尼龙柱 + M2.5 螺丝**，热熔胶只做辅助定位 |
| 板底 | 贴 0.5mm 青稞纸/聚酰亚胺胶带 |
| 电源线 | 20AWG 红黑双绞，走边缘，远离麦克风与光学窗 |
| 麦克风线 | 屏蔽线，屏蔽层单端接地 |
| micro-HDMI | 壳内 S 型弯 + 扎带 + 硅胶，做应力释放（**最容易拽掉**） |
| 喇叭 | 四周 1mm EVA 泡棉防共振 |
| 光学窗 | 外侧贴 0.1mm 防尘毛毡圈；**禁用胶水**（会污染透镜） |

---

## 9. S8 热测与整改（6h）

| 步 | 操作 | 工时 | 通过标准 |
|---|---|---|---|
| S8.1 | 25°C 环境，**锁频 800MHz**，满载（`stress-ng --cpu 1 --vm 1` + 循环 TTS + WiFi 传输） | 0.5h | 系统稳定 |
| S8.2 | 30 分钟后红外测温（**顶面手掌区 5 点**、左右侧面、底部出风口） | 0.5h | 取 5 点最高值 |
| S8.3 | 读 `/sys/class/thermal/thermal_zone0/temp` | 0.5h | — |
| S8.4 | 查降频：`cpufreq` 的 `time_in_state` 是否出现 1GHz 档 | 0.5h | **不应出现** |
| S8.5 | 判定 | 0.5h | **顶面 ≤45°C 且 SoC ≤85°C 且不降频** |
| S8.6 | 不达标 → **后备 1**：顶面靠后 1/3 开 20×40mm 细格栅（1.2mm 缝 ×8） | 2.0h | 复测降 5–8°C |
| S8.7 | 仍不达标 → **后备 2**：尾部加 5V 20mm 风扇（吸入式） | 1.5h | 复测降 12–18°C |
| S8.8 | 都不达标 → 后备 3：降频 600MHz + 关 WiFi 改有线 | 0.5h | 复测降 4–6°C，记录性能损失 |

**若三级后备都不达标**：说明「L1 板 + 鼠标形态」在散热上确实到顶，应改为开放式支架或等 T3（BeaglePlay），**不要在壳上无限加风扇**。

**开孔权衡（必须写进验收记录）：**
- 开孔率每 +1%，腔内温度约降 1.5–2.5°C，但进灰速率约 +25%；
- 底部孔会吸桌面灰尘，**约 3 个月需清一次**（拆底盖，软毛刷 + 气吹）；
- 侧面孔位于握持凹陷处，**必须倒角 0.5mm + 内侧贴 80 目网**，否则硌手；
- 顶面**不开格栅**：手掌整面贴合，开孔=手感灾难 + 烫手 + 大量进灰。只有在后备 1 才动，且只开靠后 1/3。

---

## 10. S9 语音链路（10h）—— **默认云端，本地不做识别**

> v3 的硬结论：单核 Cortex-A8 @1GHz 上，whisper tiny 慢 5–10 倍、sherpa-onnx 慢 3–5 倍，**本地 STT/TTS 不可用**。
> 所以本节只做：云端 STT/LLM/TTS + 本地预录提示音 + 规则引擎降级。

| 步 | 操作 | 工时 | 通过标准 |
|---|---|---|---|
| S9.1 | PTT 按键（GPIO，去抖 20ms，长按 200ms 触发）+ 录音门控 | 2.0h | 按住说、松开停；误触发 0 |
| S9.2 | 录音 16k/16bit/mono，opus 20ms 帧编码 | 2.0h | 3 秒录音文件 ≤ 12KB；解码回放无失真 |
| S9.3 | 接云端 STT（HTTPS 上传） | 1.5h | 3 句中文，字准确率 ≥ 90% |
| S9.4 | 接云端 LLM（OpenAI 兼容，SSE 流式）+ 分句缓冲 | 1.5h | 首 token ≤ 1.5s；按句切分 |
| S9.5 | 接云端 TTS（流式）→ USB 声卡 → PAM8403 播放 | 1.5h | 首音 ≤ 3.5s（端到端） |
| S9.6 | 预录提示音 6–10 条（16k WAV）+ 规则引擎（音量/暂停/静音/取消） | 1.0h | 断网时这些指令仍可用 |
| S9.7 | 降级：网络探测 → 超时 5s → 播报「服务慢」→ 断网播报「网络不通」 | 0.5h | 断网 ≤2s 给出语音反馈，**不尝试本地识别** |

> **注意**：不要用 piper —— 它依赖 espeak-ng（GPL-3.0），链接后你的程序整体变 GPL-3.0。本项目 P0 不用本地 TTS，若将来要用，选 sherpa-onnx TTS（Apache-2.0）且需先核实权重许可。

**降级三级（与 v3 方案 §3.4 一致）：**
1. 云端全通 → 正常；
2. 网络通但云服务超时（>5s 无首包）→ 播报「服务慢，先记下」，语音存本地队列；
3. 完全断网 → 预录提示音 + 规则引擎 + 屏幕「离线模式」。

---

## 11. S10 长跑与验收（8h）

| 步 | 操作 | 工时 | 通过标准 |
|---|---|---|---|
| S10.1 | 光标 + 语音并发压力测试 | 2.0h | 同时移动 + 说话不卡、不丢事件 |
| S10.2 | 4h 循环问答（≥200 次），有条件再跑 72h | 计时 | 无重启，RSS 增长 <10% |
| S10.3 | 30 次 HDMI 热插拔 | 1.0h | 识别率 100%，**micro-HDMI 座无松动** |
| S10.4 | 1m 跌落（可选） | 0.5h | 结构不开裂 |
| S10.5 | 完整验收表填写（**v3 §8 的 V1–V14**） | 1.5h | 全部打勾或写明不达标原因 |
| S10.6 | 归档照片/数据/源码 + **实测重量/温度/延迟** | 1.0h | 存入 `logs/` |

---

## 12. 快速故障排查表

| 现象 | 优先排查 | 处理 |
|---|---|---|
| 上电无反应 | 电源、3A 保险丝、5V 短路 | 换电源；量保险丝两端通断 |
| 反复重启 | 电源电流不足、线太细、入口电压塌陷 | 换 5V/4A；线 ≥20AWG ≤1m；测满载入口 ≥4.90V |
| 无显示但有串口日志 | micro-HDMI 转接、显示器输入源 | 换软排线转接；强制 720p |
| HDMI 偶发黑屏 | 供电跌落、micro-HDMI 接触不良 | 测入口电压；线做应力消除 |
| 串口无任何输出 | USB-TTL 接线、SD 镜像 | TX/RX 交叉；GND 共地；重烧镜像 |
| USB 设备反复掉线 | Hub 供电不足 / 上游 VBUS 未断导致冲突 | Hub 自供电；**确认已切断上游 VBUS** |
| 插上 Hub 后 BBB 起不来 | 上游 VBUS 反灌 | 立刻断电，检查 S6.4 是否执行到位 |
| 录音有电流声 | 麦克风线未屏蔽/过长 | 换屏蔽线，<3cm；mic bias 单独滤波 |
| 喇叭破音 | 无音腔/增益过高 | 做密封音腔；降增益到 70% |
| 说话时啸叫 | 麦克风与喇叭太近 | 分置两端；PTT 门控（半双工） |
| 光标完全不动 | 光学高度太高 | 减薄垫片 |
| 光标慢移正常快移飘 | 光学高度偏低 / 桌面反光 | 加 0.5mm 垫片；换鼠标垫 |
| 光标静止漂移 | 漏光/桌面反光 | 四周遮光；哑光垫 |
| 语音延迟大 | 网络 / 未做流式分句 | 检查分句缓冲；换更近的服务区 |
| 语音完全无响应 | 云端 Key 失效 / 未联网 | 看 `on_event` 的 error code |
| 顶壳烫手（>45°C） | 散热不达标 | 按 S8.6 → S8.7 → S8.8 逐级整改 |
| 重量手感差（>300g） | 铝板过厚 / 壁厚过大 | 铝板改 1.2mm；壁厚 3.0→2.4；加内部减重槽 |
| Android 息屏后不响应 | ROM 杀后台 | 按引导页加白名单 |

---

## 13. 本清单的边界（如实说明）

| 项 | 状态 |
|---|---|
| BBB 价格与供货 | 【询价】¥400–520，**国内现货不稳**，可能上浮到 ¥550+ |
| 成品 USB 鼠标模块的光学高度 | 【实测】不同模块 1.2–2.0mm 不等，必须实测后配垫片 |
| 所有温度 / 功耗 / 延迟数值 | 【实测】本文为设计目标，非实测值 |
| 3D 打印报价 | 【询价】本地打印店 30–60 元/套（ABS） |
| 模型许可证 | 【需核实】见 [许可清单](../v3/许可清单.md)；核不到一律「禁止默认商用」 |
| BBB 的 WiFi 无板载 | 事实，必须外挂 USB WiFi |
| 飞书参考链接 | ❌ 取不到（需登录），本清单未采纳其内容 |

---

*MVP 清单 v2.1 · 对应方案 v3.0（β 路线）· 未采购、未下单*
