xubicheng/advanced-desktop/bom/BOM-offline.csv

编号 | 物料 | 规格 | 数量 | 单价下限 | 单价上限 | 摊位类型 | 说明
C1 | 喇叭 | 8Ω 2W 40mm 带腔体 | 2 | 5 | 12 | 喇叭/音响配件档 | 现场可试听
C2 | 轻触开关 | 6x6x5 与 12x12x7 各若干 | 10 | 0.2 | 1 | 电子元件/开关档 | PTT键
C3 | 自锁开关 | 船型或拨动 5V/1A | 2 | 1 | 3 | 开关档 | 总电源（可选）
C4 | 洞洞板 | 5x7 / 7x9 双面镀锡 | 3 | 3 | 6 | 通用PCB档
C5 | 排针排母 | 2.54mm 单排 40P | 4 | 2 | 4 | 接插件档 | 可拆长度
C6 | DC插头插座 | 5.5x2.1 公头+母座 | 4 | 1 | 3 | 接插件档
C7 | XH2.54端子线 | 2P/3P/4P 20cm | 6 | 2 | 4 | 线材/接插件档 | 比杜邦线牢
C8 | 硅胶线 | 20AWG 红黑各2m | 1 | 10 | 20 | 线材档 | 电源主线
C9 | 热缩管 | 混装 | 1 | 8 | 15 | 线材档
C10 | 螺丝螺母 | M2.5/M3 混装 | 1 | 10 | 20 | 五金档 | 现场配更准
C11 | 铝板 | 1.5-2mm 边角料 | 1 | 10 | 30 | 五金/金属材料档 | 底盖
C12 | 电源适配器 | 5V 4A DC5.5x2.1 | 1 | 30 | 50 | 电源/适配器档 | 可要求现场实测电压
C13 | 双面胶 | 3M 强力型 | 1 | 10 | 10 | 五金/胶带档
C14 | 尼龙扎带 | 小号 | 1 | 5 | 5 | 五金档
C15 | 泡棉 | 3mm 防震棉 | 1 | 5 | 10 | 包装/材料档
