xubicheng/advanced-desktop/bom/BOM-taobao.csv

分组 | 编号 | 物料 | 建议型号规格 | 数量 | 单价下限 | 单价上限 | 搜索关键词 | 备注
关键路径 | A1 | 主控板 | BeagleBone Black Rev C (AM3358/512MB/4GB eMMC) | 1 | 400 | 520 | BeagleBone Black / BBB 开发板 AM3358 | 需询价；确认 Rev C + 4GB eMMC + 含电源
关键路径 | A2 | 4口USB Hub模块 | FE1.1s 4口 USB2.0 自供电 带5V外供焊盘 | 1 | 15 | 30 | FE1.1s 4口 USB HUB 模块 带供电 | 确认有外供焊盘；GL850G 备选；不要带DC座的成品
关键路径 | A3 | 成品USB鼠标模块 | USB HID 光学鼠标主板+透镜 800-1600DPI | 2 | 25 | 60 | USB 鼠标模块 光学 透镜 改装 | 买2个不同型号；不要买成无线接收器
关键路径 | A4 | USB声卡 | CM108/SSS1629 3.5mm麦入+耳机出 免驱 | 1 | 15 | 35 | USB声卡 免驱 CM108 | 必须带麦克风输入
关键路径 | A5 | USB WiFi | RTL8188EU/RTL8192EU 带SMA外置天线 | 1 | 20 | 40 | USB无线网卡 8188EU 外置天线 | 不要买 8811CU/8821CU
关键路径 | A6 | 功放板 | PAM8403 2x3W 5V 带LC滤波 | 1 | 5 | 10 | PAM8403 功放板 5V 带滤波
关键路径 | A7 | 喇叭 | 8Ω 2W 40mm 带腔体 | 1 | 5 | 12 | 8欧2W 喇叭 40mm 腔体 | 也可线下
关键路径 | A8 | 麦克风模块 | MAX9814/MAX4466 带AGC | 1 | 8 | 20 | MAX9814 麦克风 模块 AGC | 必须带AGC
关键路径 | A9 | 电源适配器 | 5V 4A 20W DC5.5x2.1 | 1 | 25 | 45 | 5V4A 电源适配器 DC5.5 | 虚标严重；须实测满载≥4.90V
关键路径 | A10 | DC母座 | 5.5x2.1 焊板式 带螺纹 | 1 | 2 | 5 | DC座 5.5*2.1 焊板 螺纹
关键路径 | A11 | micro-HDMI转接 | micro-HDMI公转HDMI母 软排线 20cm | 1 | 20 | 40 | micro HDMI 转 HDMI 母 软排线 | 必须软排线；不要硬转接头
关键路径 | A12 | HDMI线 | 2m HDMI 2.0 | 1 | 15 | 30 | HDMI线 2米 2.0
关键路径 | A13 | 保险丝 | 5x20座+3A慢断 | 1 | 5 | 10 | 保险丝座 5*20 带线 / 3A 慢断 | 不要用1.1A自恢复
关键路径 | A14 | TVS二极管 | SMAJ5.0A SMB | 4 | 1 | 2 | SMAJ5.0A TVS
关键路径 | A15 | 肖特基二极管 | SS54 SMA | 2 | 1 | 2 | SS54 肖特基 SMA | 防反接/Hub VBUS隔离
关键路径 | A16 | 铝散热片 | 20x20x8mm 鳍片 | 1 | 2 | 5 | 铝散热片 20*20*8 | 不要超过8mm
关键路径 | A17 | 导热垫 | 1.0mm ≥3W/mK 20x20 | 2 | 5 | 15 | 导热硅胶垫 1mm 3W | 另备0.5mm
关键路径 | A18 | 防尘网 | 80目尼龙网 20x20cm | 1 | 5 | 10 | 80目 尼龙 防尘网
关键路径 | A19 | 螺丝铜柱 | M2.5x6/8/10 + 6mm铜柱+螺母 套装 | 1 | 15 | 25 | M2.5 螺丝 铜柱 套装 | 下单前量BBB安装孔
关键路径 | A20 | 硅胶线 | 20AWG 红黑各2m | 1 | 10 | 20 | 20AWG 硅胶线 红黑
关键路径 | A21 | 热缩管 | φ1.5-8mm 混装 | 1 | 10 | 15 | 热缩管 套装
关键路径 | A22 | ABS耗材 | 1.75mm 1kg 本色或深灰 | 1 | 60 | 90 | ABS 耗材 1.75 1kg | 必须ABS；不要PETG/PLA
关键路径 | A23 | 5052铝板 | 1.5mm x150x200mm | 1 | 20 | 40 | 5052铝板 1.5mm | 底盖兼配重
可延后 | B1 | 备用鼠标模块 | 与A3不同型号 | 1 | 30 | 60 | 同A3 | 光学高度不匹配时唯一解法
可延后 | B2 | 5V风扇 | 20x20 5V ≤0.1A 含滤网 | 1 | 15 | 30 | 5V 20mm 风扇 涡轮 | 仅散热不达标时买
工具 | B3 | USB电流表 | 带电压电流功率显示 | 1 | 20 | 40 | USB 电流表 测试仪
工具 | B4 | 红外测温枪 | -50~380C ±2C | 1 | 60 | 120 | 红外测温枪 工业 | 散热验收必需
工具 | B5 | USB-TTL串口 | CH340 3.3V/5V | 1 | 10 | 15 | CH340 USB转TTL | BBB调试串口
工具 | B6 | 电烙铁套装 | 60W 可调温+多嘴+吸锡器 | 1 | 60 | 150 | 电烙铁 套装 可调温 60W | 已有可省
工具 | B7 | 万用表 | 自动量程 带通断/电容 | 1 | 60 | 150 | 万用表 自动量程 | 必需
耗材 | B8 | 杜邦线 | 母对母/公对母 20cm | 1 | 10 | 10 | 杜邦线 20cm 套装
耗材 | B9 | EVA泡棉 | 3mm 带背胶 | 1 | 8 | 15 | EVA 泡棉 3mm 背胶 | 喇叭音腔隔振
耗材 | B10 | 扎带+双面胶 | 小号 | 1 | 10 | 10 | 尼龙扎带 小号
耗材 | B11 | 洞洞板 | 5x7cm 双面镀锡 | 2 | 3 | 6 | 洞洞板 5*7 双面
耗材 | B12 | 排针排母 | 2.54mm 单排 | 2 | 5 | 5 | 2.54 排针 排母
