xubicheng/advanced-desktop/AD-电子元器件询价单-20261110.xlsx

Sheet: 询价单
AD 项目 · 电子元器件询价单（RFQ）
项目：AD（Advanced Desktop）鼠标形无屏微型计算机 |  |  |  | 阶段：设计 v4，样机选料，未下单 |  |  |  |  | 日期：2026-11-10 |  |  | 币种：人民币 |  | 询价单号：RFQ-AD-20261110
需求：单台样机 1 套（部分件 2 件备损） |  |  |  | 价格口径：目标价/估算区间，非承诺价 |  |  |  |  | 请供应商填写浅蓝色区域：报价单价 / 可供数量 / 交期 / 品牌或替代型号
序号 | 分类 | 物料 | 关键规格（不可妥协） | 数量 | 目标单价 下限(¥) | 目标单价 上限(¥) | 目标金额 下限(¥) | 目标金额 上限(¥) | 供应商 报价单价(¥) | 报价小计 (¥) | 可供 数量 | 交期 (天) | 品牌 / 替代型号 | 必须书面确认 | 备注 / 避坑
A1 | 核心计算 | BeagleBone Black 主控板 | Rev C；AM3358 / 512MB / 4GB eMMC | 1 | 400 | 520 | ¥400 | ¥520 |  |  |  |  |  | ① 是否 Rev C ② 是否 4GB eMMC ③ 是否含 DC 电源 ④ 现货数与交期；断货请同时报 BBB Wireless | 国内现货少，多为代购/二手
A2 | 接口扩展 | 4 口 USB 2.0 Hub 模块 | FE1.1s 方案，4 口，板上有 5V 外供焊盘 | 1 | 15 | 30 | ¥15 | ¥30 |  |  |  |  |  | 有无 5V 外供焊盘或可割线；GL850G 备选是否可报 | 不要带 DC 座的成品 Hub（塞不进壳）
A3 | 人机输入 | 成品 USB 鼠标模块（含光学透镜） | USB HID 光学主板 + 透镜，800–1600 DPI | 2 | 25 | 60 | ¥50 | ¥120 |  |  |  |  |  | 是否为「插上即鼠标」的完整 HID；确认非无线接收模块；报 2 个不同型号 | 全项目风险最高的一件
A4 | 音频 | USB 声卡 | CM108 / SSS1629，3.5mm 麦入 + 耳机出，免驱 | 1 | 15 | 35 | ¥15 | ¥35 |  |  |  |  |  | 必须有麦克风输入；注明主控芯片型号 | 很多迷你声卡只有输出
A5 | 接口扩展 | USB WiFi（SMA 外置天线） | RTL8188EU 或 RTL8192EU，SMA 外置天线 | 1 | 20 | 40 | ¥20 | ¥40 |  |  |  |  |  | 仅接受上述两颗主控；请提供 Linux 驱动情况；不要 8811CU/8821CU | BBB 无板载 WiFi
A6 | 音频 | PAM8403 功放板 | 2×3W D 类，5V 供电，带 LC 输入滤波 | 1 | 5 | 10 | ¥5 | ¥10 |  |  |  |  |  | 是否带 LC 输入滤波 | 否则底噪与 WiFi 啸叫
A7 | 音频 | 喇叭 | 8Ω 2W，40mm 圆形，带独立腔体 | 1 | 5 | 12 | ¥5 | ¥12 |  |  |  |  |  | 腔体外径与厚度尺寸 | 带腔体比裸喇叭好装
A8 | 音频 | 麦克风模块 | MAX9814 / MAX4466，带 AGC，模拟输出 | 1 | 8 | 20 | ¥8 | ¥20 |  |  |  |  |  | 是否带 AGC 放大 | 裸驻极体接声卡电平太低
A9 | 供电保护 | 电源适配器 | 5V / 4A（20W），DC 5.5×2.1 输出 | 1 | 25 | 45 | ¥25 | ¥45 |  |  |  |  |  | 满载电压能否保证 ≥4.90V；可否先寄 1 只实测；注明真实额定功率 | 市面虚标严重，最易翻车
A10 | 供电保护 | DC 母座 | 5.5×2.1 焊板式，带螺纹固定 | 1 | 2 | 5 | ¥2 | ¥5 |  |  |  |  |  | 螺纹规格 | 可线下买
A11 | 视频 | micro-HDMI 公转 HDMI 母 软排线 | Type-D 公转 Type-A 母，20cm | 1 | 20 | 40 | ¥20 | ¥40 |  |  |  |  |  | 必须软排线款，不要硬直角转接头 | 硬接头会拽掉 BBB 的 HDMI 座
A12 | 视频 | HDMI 线 | 2m，HDMI 2.0 | 1 | 15 | 30 | ¥15 | ¥30 |  |  |  |  |  | — | 720p 对线材不挑
A13 | 供电保护 | 保险丝座 + 保险丝 | 5×20 玻璃管座 + 3A 慢断 | 1 | 5 | 10 | ¥5 | ¥10 |  |  |  |  |  | 确认为 3A 慢断，不要 1.1A 自恢复 | 峰值 2.76A 会误跳
A14 | 供电保护 | TVS 二极管 | SMAJ5.0A，SMB 封装 | 4 | 1 | 2 | ¥4 | ¥8 |  |  |  |  |  | 品牌 / 批次 | 过压保护
A15 | 供电保护 | 肖特基二极管 | SS54（5A 40V），SMA 封装 | 2 | 1 | 2 | ¥2 | ¥4 |  |  |  |  |  | — | 防反接 / VBUS 隔离
A16 | 散热 | 铝散热片 | 20×20×8mm 鳍片 | 1 | 2 | 5 | ¥2 | ¥5 |  |  |  |  |  | 高度不得超过 8mm | 超高超厚装不进去
A17 | 散热 | 导热垫 | 1.0mm，导热系数 ≥3W/m·K，20×20 | 2 | 5 | 15 | ¥10 | ¥30 |  |  |  |  |  | 请同时报 0.5mm 同款 | 按 SoC 与散热片间隙微调
A18 | 散热 | 防尘网 | 80 目尼龙网，20×20cm | 1 | 5 | 10 | ¥5 | ¥10 |  |  |  |  |  | — | 贴侧面进风口内侧
A19 | 结构 | M2.5 螺丝 + 铜柱套装 | M2.5×6/8/10 螺丝 + 6mm 铜柱 + 螺母 | 1 | 15 | 25 | ¥15 | ¥25 |  |  |  |  |  | 是否可混装 | 下单前量 BBB 安装孔
A20 | 线材耗材 | 硅胶线 | 20AWG，红黑各 2m | 1 | 10 | 20 | ¥10 | ¥20 |  |  |  |  |  | 确认线径 20AWG | 电源主线不得更细
A21 | 线材耗材 | 热缩管套装 | φ1.5–8mm 混装 | 1 | 10 | 15 | ¥10 | ¥15 |  |  |  |  |  | —
A22 | 结构 | ABS 3D 打印耗材 | 1.75mm，1kg，本色或深灰 | 1 | 60 | 90 | ¥60 | ¥90 |  |  |  |  |  | 必须 ABS；不要 PETG / PLA | 耐温与后处理要求
A23 | 结构 | 5052 铝板 | 1.5mm × 150 × 200mm | 1 | 20 | 40 | ¥20 | ¥40 |  |  |  |  |  | 是否可切割，加工费另报 | 底盖兼配重
B1 | 可选件 | 备用鼠标模块 | 与 A3 不同型号 | 1 | 30 | 60 | ¥30 | ¥60 |  |  |  |  |  | 型号须与 A3 不同 | 强烈建议同时买
B2 | 可选件 | 5V 风扇 | 20×20mm，≤0.1A，含滤网 | 1 | 15 | 30 | ¥15 | ¥30 |  |  |  |  |  | — | 仅散热不达标时采购
合计（单台 BOM；A1–A23 为必需，B1–B2 为可选） |  |  |  |  |  |  | ¥768 | ¥1254 | 报价合计 → | ¥0 | 报价合计（供应商填写报价单价后自动汇总）
注：表中价格为目标价/区间估算，不构成报价承诺；最终以供应商正式报价单为准。关键件（电源、鼠标模块、声卡、WiFi）请先各寄 1 件样品验证；B1–B2 为可选件，不需要可直接删行。

Sheet: 对接须知
AD 项目 · 供应商对接须知
一、项目背景
· AD = Advanced Desktop：把一台计算机做进鼠标，BeagleBone Black + 语音输入输出，屏幕为可选外设。
· 当前为设计 v4 阶段，单台样机选料，全部小批量现货，不做量产，不接受长交期期货。
· 本表只含电子与结构件，不含开发工具（万用表、电烙铁、测温枪等）。
二、报价与商务要求
项目 | 要求
报价币种 | 人民币，含 13% 增值税
报价口径 | 单价 + 小批（1–2 件）价格，并注明 MOQ
交期 | 填写最晚发货日（自然日），不接受「尽快」
替代料 | 须注明型号差异与价差；关键规格不得擅自替换
样品 | 电源、鼠标模块、声卡、WiFi 先各寄 1 件验证
质保 | 非人为损坏 7 天内可换
报价有效期 | 不少于 15 天
三、五个最容易买错的点（下单前逐条核对）
易错点 | 后果 | 核对方法
5V/4A 电源虚标 | 满载欠压重启，误判为主板故障 | 收到后立即带载测电压，≥4.90V 才算合格
鼠标模块买成无线接收器 | 不是 HID 设备，插上没反应 | 确认含「光学传感器 + 透镜」，问「插 USB 就能当鼠标用吗」
USB 声卡只有输出没有输入 | 录不了音，语音链路断开 | 有 3.5mm Mic 口，或主控为 CM108 / SSS1629
USB WiFi 驱动不支持 | 内核不认，设备无网络 | 只买 RTL8188EU / RTL8192EU
micro-HDMI 买成硬转接头 | 拽掉 BBB 的 HDMI 座 | 必须是软排线款
四、BeagleBone Black 断供降级链
级别 | 型号 | 说明
T0（主选） | BeagleBone Black Rev C | 基准，优先报价
T1 | BeagleBone Black Wireless | 去 RJ45、加板载 WiFi；可省一个 USB 口与 13.5mm 高度，优先询问
T2 | BeagleBone Green / Green Wireless | micro-USB 供电仅 1A，需自改 5V 输入
T3 | BeaglePlay | 89×70mm 会破坏鼠标外壳形态，仅作最后手段
五、样品与验收
· 关键件先各 1 件样品，验证通过后再补齐数量。
· 到货 24 小时内核对型号、数量、封装，不符立即反馈。
· 电源需记录满载电压；散热件需记录实测温度。
· 本表价格为估算区间，最终以下单时的正式报价单为准。
