xubicheng/advanced-desktop/docs/v3/采购清单-淘宝优先.md

# AD · 采购清单（淘宝优先）

| 项目 | 内容 |
|---|---|
| 版本 | v3.0 |
| 日期 | 2026-11-06 |
| 状态 | **清单，未下单** |
| 价格口径 | 人民币含税包邮估算区间；标「需询价」的表示该品类价格波动大或供货不稳，**不得当作报价使用** |
| 采购原则 | **核心件全部淘宝**；线下（南京金盛 / 华龙）只买通用件（喇叭、开关、洞洞板、电源、五金、线材） |

> 说明：淘宝型号与链接会失效，本文只给**规格 + 搜索关键词**，不给具体店铺。下单前必须核对规格，不要只看图。

---

## 表 A：淘宝采购单

### A-1 关键路径（没有它开不了工）

| # | 物料 | 建议型号 / 规格 | 数量 | 单价区间 | 搜索关键词 | 备注与避坑 |
|---|---|---|---|---|---|---|
| A1 | **BeagleBone Black 主控板** | BBB Rev C，AM3358 / 512MB / 4GB eMMC | 1 | **¥400–520（需询价）** | `BeagleBone Black` `BBB 开发板 AM3358` | 国内现货少，多为代购或二手。**必须确认：① 是 Rev C；② 带 4GB eMMC；③ 含 DC 电源（很多不含）**。**买不到就看 §3.6 降级链，先询 BBB Wireless** |
| A2 | **4 口 USB 2.0 自供电 Hub 模块** | FE1.1s 方案，4 口，**板上有 5V 外供焊盘** | 1 | ¥15–30 | `FE1.1s 4口 USB HUB 模块 带供电` | **必须确认有 5V 外供焊盘或可割线**；GL850G 可作备选。**不要买带 DC 座的成品 Hub**（体积塞不进） |
| A3 | **成品 USB 鼠标模块（含光学透镜）** | USB HID 光学鼠标主板 + 透镜 + 支架，800–1600 DPI | 2 | ¥25–60 | `USB 鼠标模块 光学 透镜 改装` `鼠标主板 改装 USB` | **买 2 个不同型号**（R2 风险最高的一件）。**别买成无线鼠标的接收器模块**；确认是「插上就是鼠标」的完整 HID 设备 |
| A4 | **USB 声卡** | CM108 / SSS1629 / HS100B，3.5mm 麦入 + 耳机出，免驱 | 1 | ¥15–35 | `USB声卡 免驱 CM108` `USB声卡 3.5mm 麦克风输入` | **必须带麦克风输入**（很多迷你声卡只有输出）。认出芯片型号再买 |
| A5 | **USB WiFi（带外置天线）** | RTL8188EU 或 RTL8192EU，SMA 外置天线 | 1 | ¥20–40 | `USB无线网卡 8188EU 外置天线` | **不要买 RTL8811CU/8821CU**（Linux 驱动麻烦）。BBB 无板载 WiFi，天线必须能引出到壳尾 |
| A6 | **PAM8403 功放板** | 2×3W D 类，5V 供电，带输入滤波 | 1 | ¥5–10 | `PAM8403 功放板 5V 带滤波` | 买**带 LC 滤波**的版本，否则有底噪与 WiFi 干扰啸叫 |
| A7 | **喇叭** | 8Ω 2W，40mm 或 36mm 圆形，带腔体 | 1 | ¥5–12 | `8欧2W 喇叭 40mm 腔体` | 也可线下买（表 B）。**带独立腔体**的比裸喇叭好装 |
| A8 | **驻极体麦克风模块（带 AGC）** | MAX9814 或 MAX4466 模块，模拟输出 | 1 | ¥8–20 | `MAX9814 麦克风 模块 AGC` | **必须带 AGC/放大**，裸驻极体直接接声卡的 Mic-in 电平太低。也可用 USB 声卡自带麦，但音质差 |
| A9 | **5V 电源适配器** | **5V / 4A（20W）**，DC 5.5×2.1 输出，带线损补偿更佳 | 1 | ¥25–45 | `5V4A 电源适配器 DC5.5` `5V4A 工业电源` | **这是最容易翻车的一件**：市面 5V4A 虚标严重。**认准重量与线径**，收到后必须实测满载电压 ≥4.90V（V2 验收）。不建议省到 3A |
| A10 | **DC 母座 5.5×2.1** | 焊板式，带螺纹固定 | 1 | ¥2–5 | `DC座 5.5*2.1 焊板 螺纹` | 也可线下买 |
| A11 | **micro-HDMI 公 → HDMI 母 软排线** | 20 cm，Type D 转 Type A 母 | 1 | ¥20–40 | `micro HDMI 转 HDMI 母 软排线` | **必须买软排线款，不要买硬的直角转接头**——硬接头会把 BBB 的 micro-HDMI 座拽掉（BBB 高发故障） |
| A12 | **HDMI 线** | 2 m，HDMI 2.0 | 1 | ¥15–30 | `HDMI线 2米 2.0` | 720p 对线材不挑，任意合格线 |
| A13 | **保险丝座 + 3A 保险丝** | 5×20 玻璃管座 + 3A 慢断 | 1 套 | ¥5–10 | `保险丝座 5*20 带线` `3A 慢断 保险丝` | **注意：不要用 1.1A 自恢复保险丝**（峰值 2.76A 会误跳），见 v3 方案 §3.5 |
| A14 | **TVS 二极管** | SMAJ5.0A（SMB 封装） | 4 | ¥1–2/只 | `SMAJ5.0A TVS` | 过压保护 |
| A15 | **肖特基二极管** | SS54（5A 40V，SMA） | 2 | ¥1–2/只 | `SS54 肖特基 SMA` | 防反接 / Hub VBUS 隔离（§3.2 方案 B） |
| A16 | **铝散热片** | 20×20×8 mm，鳍片，带背胶或自贴 | 1 | ¥2–5 | `铝散热片 20*20*8` | |
| A17 | **导热垫** | 1.0 mm，导热系数 ≥3 W/m·K，20×20 | 2 | ¥5–15 | `导热硅胶垫 1mm 3W` | 厚度按 SoC 与散热片实际间隙微调，另备 0.5mm |
| A18 | **防尘网** | 80 目尼龙网，20×20 cm | 1 | ¥5–10 | `80目 尼龙 防尘网` | 贴在侧面进风口内侧 |
| A19 | **M2.5 螺丝 + 铜柱套装** | M2.5×6/8/10 螺丝 + 6mm 铜柱 + 螺母 | 1 套 | ¥15–25 | `M2.5 螺丝 铜柱 套装` | BBB 安装孔是 M2.5 或 M3，**下单前量一下** |
| A20 | **硅胶线 20AWG** | 红黑各 2 m | 1 套 | ¥10–20 | `20AWG 硅胶线 红黑` | 电源线必须 ≥20AWG，见 §3.5 |
| A21 | **热缩管套装** | φ1.5–8 mm 混装 | 1 盒 | ¥10–15 | `热缩管 套装` | |
| A22 | **ABS 3D 打印耗材** | 1.75mm，1 kg，本色或深灰 | 1 卷 | ¥60–90 | `ABS 耗材 1.75 1kg` | **必须 ABS，不要 PETG/PLA**（§6.2）。若外发打印可省 |
| A23 | **5052 铝板** | 1.5 mm × 150 × 200 mm | 1 | ¥20–40 | `5052铝板 1.5mm` | 做底盖兼配重；线下也可能有 |

**A-1 小计：¥700–915（含耗材，未含工具）**

### A-2 可延后（先不做也能跑通链路）

| # | 物料 | 建议规格 | 数量 | 单价区间 | 搜索关键词 | 说明 |
|---|---|---|---|---|---|---|
| B1 | 备用鼠标模块 | 与 A3 不同型号 | 1 | ¥30–60 | 同 A3 | 强烈建议：光学高度不匹配时唯一的解法就是换模块 |
| B2 | 5V 20×20 风扇 | 5V，≤0.1A，含滤网 | 1 | ¥15–30 | `5V 20mm 风扇 涡轮` | **仅当 V9 散热超 45°C 时才买**（后备 2） |
| B3 | USB 电流表 | 带电压/电流/功率显示，USB-A 串联型 | 1 | ¥20–40 | `USB 电流表 测试仪` | 测电流预算的必备工具，建议提前买 |
| B4 | 红外测温枪 | -50~380°C，精度 ±2°C | 1 | ¥60–120 | `红外测温枪 工业` | **V9 散热验收必需**，不能靠手摸 |
| B5 | USB-TTL 串口 | CH340，3.3V/5V 可选 | 1 | ¥10–15 | `CH340 USB转TTL` | BBB 调试串口（救砖必备） |
| B6 | 电烙铁套装 | 60W 可调温 + 多嘴 + 吸锡器 | 1 | ¥60–150 | `电烙铁 套装 可调温 60W` | 已有可省 |
| B7 | 万用表 | 自动量程，带通断/电容 | 1 | ¥60–150 | `万用表 自动量程` | **V1/V2/V5 验收必需** |
| B8 | 杜邦线 / 端子 | 母对母 / 公对母，20cm | 各 1 排 | ¥10 | `杜邦线 20cm 套装` | |
| B9 | 泡棉 / EVA | 3 mm 厚，带背胶 | 1 片 | ¥8–15 | `EVA 泡棉 3mm 背胶` | 喇叭音腔隔振 |
| B10 | 尼龙扎带 + 双面胶 | 小号 | 1 套 | ¥10 | `尼龙扎带 小号` | 走线固定 |
| B11 | 洞洞板 | 5×7 cm 双面镀锡 | 2 | ¥3–6 | `洞洞板 5*7 双面` | 也可线下买 |
| B12 | 排针排母 | 2.54mm 单排 | 各 2 | ¥5 | `2.54 排针 排母` | |

**A-2 小计：¥220–600（其中工具类 ¥150–450，属一次性投入）**

---

## 表 B：线下采购单（南京金盛 / 华龙）

| # | 物料 | 规格 | 数量 | 单价 | 摊位类型 | 说明 |
|---|---|---|---|---|---|---|
| C1 | 喇叭 | 8Ω 2W，40mm，带腔体 | 1–2 | ¥5–12 | 喇叭 / 音响配件档 | 现场可试听，比网购靠谱 |
| C2 | 轻触开关 | 6×6×5 mm 与 12×12×7 mm 各若干 | 10 | ¥0.2–1/个 | 电子元件 / 开关档 | PTT 键、复位键 |
| C3 | 自锁开关 | 船型或拨动，5V/1A | 2 | ¥1–3 | 开关档 | 总电源开关（可选） |
| C4 | 洞洞板 | 5×7 / 7×9 cm 双面镀锡 | 2–3 | ¥3–6 | 通用 PCB / 洞洞板档 | Hub 与功放的固定底板 |
| C5 | 排针排母 | 2.54mm，单排 40P | 各 2 | ¥2–4 | 接插件档 | 可拆成所需长度 |
| C6 | DC 插头 / 插座 | 5.5×2.1 公头 + 母座 | 各 2 | ¥1–3 | 接插件档 | 备用 |
| C7 | XH2.54 端子线 | 2P/3P/4P，20cm | 各 2 | ¥2–4/根 | 线材 / 接插件档 | 比杜邦线牢靠，适合电源与喇叭 |
| C8 | 硅胶线 | 20AWG 红黑，各 2 m | 1 套 | ¥10–20 | 线材档 | 电源主线 |
| C9 | 热缩管 | 混装 | 1 盒 | ¥8–15 | 线材档 | |
| C10 | 螺丝螺母 | M2.5 / M3 混装 | 1 盒 | ¥10–20 | 五金档 | 现场配更准 |
| C11 | 铝板 / 铝型材边角料 | 1.5–2 mm 厚 | 1 块 | ¥10–30 | 五金 / 金属材料档 | 底盖；没有就网购（A23） |
| C12 | 电源适配器 | 5V 4A，DC 5.5×2.1 | 1 | ¥30–50 | 电源 / 适配器档 | **现场可要求实测输出电压**，比网购可控 |
| C13 | 双面胶 / 3M 胶带 | 强力型 | 1 | ¥10 | 五金 / 胶带档 | |
| C14 | 尼龙扎带 | 小号 | 1 包 | ¥5 | 五金档 | |
| C15 | 泡棉 / 防震棉 | 3 mm | 1 片 | ¥5–10 | 包装 / 材料档 | |

**表 B 小计：¥110–280**（大部分与表 A 重叠，可按「线下买省运费」原则二选一）

---

## 3. 总预算

### 3.1 必需（Minimum Viable Hardware）

| 分项 | 金额区间 | 说明 |
|---|---|---|
| 核心板（BBB） | ¥400–520 | **占预算 45%**，且供货最不确定 |
| 外设模块（Hub / 鼠标 / 声卡 / WiFi） | ¥75–165 | |
| 音频（功放 / 喇叭 / 麦） | ¥18–42 | |
| 供电（电源 / 座 / 保险丝 / TVS / 肖特基） | ¥35–65 | |
| 视频（转接 / 线） | ¥35–70 | |
| 散热（散热片 / 导热垫 / 防尘网） | ¥12–30 | |
| 结构（ABS / 铝板 / 螺丝 / 线材 / 热缩） | ¥115–185 | |
| **硬件 BOM 合计** | **¥690–1077** | |
| 工具（电烙铁 / 万用表 / 测温枪 / 电流表 / USB-TTL） | ¥150–450 | 一次性投入，已有可省 |
| **必需总计** | **¥840–1527** | |

### 3.2 可选

| 分项 | 金额 | 何时买 |
|---|---|---|
| 备用鼠标模块 | ¥30–60 | 建议现在就买（R2 风险最高） |
| 5V 20mm 风扇 + 滤网 | ¥15–30 | V9 测试超 45°C 时 |
| 减重版外壳耗材 | ¥60–90 | 手感反馈「太重」时 |
| 备用 Hub / 声卡 | ¥30–65 | 调试期建议 |

### 3.3 一次性 NRE

| 项 | 金额 | 说明 |
|---|---|---|
| 3D 打印外发（终版外壳，SLA/SLS） | ¥120–300 | 自打印为 ¥0（耗材已计入） |
| PCB 打样（若 P1 自研载板） | ¥50–100（5 片，嘉立创级别） | **P0 不做**，用洞洞板 + 模块 |
| 激光切割铝底板 | ¥30–60 | 手工锯 + 锉为 ¥0 |
| **NRE 合计** | **¥0–460** | |

### 3.4 汇总

| 口径 | 金额 |
|---|---|
| **最低可行（全自打印、工具已有）** | **≈ ¥690** |
| **典型（工具全买、外发打印）** | **≈ ¥1,600** |
| **舒适（含全部可选与备用件）** | **≈ ¥2,100** |

---

## 4. 下单顺序建议

```
第 1 批（本周，决定项目能不能开工）
  A1 BBB（先询价，若断货立刻转 BBB Wireless）
  A3 鼠标模块 ×2（风险最高，早买早试）
  A2 Hub
  A9 电源 + A10 DC 座 + A13 保险丝 + A14 TVS + A15 SS54
  B7 万用表

第 2 批（BBB 到货前）
  A4 声卡 + A5 WiFi + A6 功放 + A7 喇叭 + A8 麦
  A11 micro-HDMI 转接 + A12 HDMI 线
  A16 散热片 + A17 导热垫 + A18 防尘网
  B4 测温枪 + B3 电流表

第 3 批（结构件，等电路验证通过再买）
  A22 ABS + A23 铝板 + A19 螺丝 + A20 线材 + A21 热缩管
  B9 泡棉 + B10 扎带

第 4 批（按测试结果决定）
  B2 风扇（仅散热不达标时）
```

---

## 5. 五个最容易买错的点（照单核对）

| # | 易错点 | 后果 | 核对方法 |
|---|---|---|---|
| 1 | **5V4A 电源虚标** | 满载欠压重启，误判为 BBB 坏了 | 收到后立刻带载测电压，≥4.90V 才算合格 |
| 2 | **买成无线鼠标的接收模块** | 不是 HID 设备，插上没反应 | 看描述里有没有「光学传感器 + 透镜」，或问客服「插 USB 就能当鼠标用吗」 |
| 3 | **USB 声卡只有输出没有输入** | 录不了音 | 看有没有 3.5mm 粉色/红色 Mic 口，或芯片是 CM108/SSS1629 |
| 4 | **USB WiFi 驱动不支持** | 内核不认，无网络 | 只买 RTL8188EU / RTL8192EU |
| 5 | **micro-HDMI 买成硬转接头** | 拽掉 BBB 的 HDMI 座 | 必须是「软排线」款 |

---

## 6. 未做与不做的事

- **未下单、未询价、未访问任何购物站点**（按用户要求）；
- 所有价格是**区间估算**，不是报价；BBB 的实际到手价可能显著高于区间上限；
- 未提供店铺链接——链接失效快，且不替用户做店铺背书。
