xubicheng/advanced-desktop/docs/v3/许可清单.md

# AD · 第三方组件许可清单（v3）

| 项目 | 内容 |
|---|---|
| 版本 | v3.0 |
| 日期 | 2026-11-06 |
| 原则 | **D5：核心程序只允许 Apache-2.0 / MIT / BSD 类宽松许可；不把 GPL 库链接进核心；允许 GPL 工具以独立进程 / CLI 方式调用** |
| 核实方法 | 对「代码仓库」逐一下载 `LICENSE` 原文确认；对「模型权重」查其发布页（HuggingFace / ModelScope）许可字段。**核不到的一律标「未核实，禁止默认商用」** |
| 核实日期 | 2026-11-06（仓库默认分支快照，**落地时必须锁定 commit 再核一次**） |

> 法律声明：本文是工程判断，不是法律意见。对外商用发布前，涉模型权重的条目必须由法务复核。

---

## 0. 我方产出许可

| 产出 | 许可证 | 文件 |
|---|---|---|
| 软件代码（`software/`） | **MIT** | `LICENSE-CODE` |
| 硬件设计（`hardware/`：KiCad、FreeCAD/OpenSCAD、装配图） | **CERN-OHL-S-2.0** | `LICENSE-HARDWARE` |
| 文档（`docs/`、`bom/`、`logs/`） | **CC-BY-4.0** | `LICENSE-DOCS` |

三者互不传染：MIT 代码可被任何人用于闭源产品；CERN-OHL-S 是强互惠（修改硬件设计必须以同许可公开）；CC-BY 仅要求署名。

---

## 1. 核心运行时依赖（Rust）

| 组件 | 版本锁定策略 | 许可证 | 链接进核心 | 隔离方式 | 风险 |
|---|---|---|---|---|---|
| `tokio` | `1.x`（`Cargo.lock` 固定） | MIT | 是 | 无需 | 低 |
| `serde` / `serde_json` | `1.x` | MIT OR Apache-2.0 | 是 | 无需 | 低 |
| `reqwest` | `0.12.x` | MIT OR Apache-2.0 | 是 | 无需 | 低 |
| `rustls` | `0.23.x` | Apache-2.0 OR ISC OR MIT | 是 | 无需 | 低 |
| `ring` | `0.17.x` | **ISC + OpenSSL 例外条款** | 是 | 需在 THIRD-PARTY 单列其例外条款原文 | 低-中 |
| `opus`（libopus 静态） | `0.3.x` / libopus 1.4+ | **BSD-3-Clause** | 是 | 无需（BSD 需保留版权声明） | 低 |
| `rubato` | `0.15.x` | MIT | 是 | 无需 | 低 |
| `tracing` / `tracing-subscriber` | `0.1.x` / `0.3.x` | MIT | 是 | 无需 | 低 |
| `thiserror` / `anyhow` | `1.x` | MIT OR Apache-2.0 | 是 | 无需 | 低 |
| `jni` | `0.21.x` | MIT OR Apache-2.0 | 是（仅 Android feature） | 无需 | 低 |
| `cpal`（BBB / 桌面临时） | `0.15.x` | MIT OR Apache-2.0 | 是 | 无需 | 低 |
| `gilrs`（游戏手柄，可选） | `0.11.x` | MIT OR Apache-2.0 | 是 | 无需 | 低 |

**结论：核心依赖全部宽松，无 GPL/AGPL。** 唯一需要留意的是 `ring` 的 OpenSSL 例外条款——它要求在你分发二进制时**保留其许可证与免责声明文本**，已在 `THIRD-PARTY.md` 中列出。

---

## 2. 语音：运行时与模型（本轮重点排查）

### 2.1 运行时

| 组件 | 许可证（已核实） | 核实来源 | 链接进核心 | 结论 |
|---|---|---|---|---|
| **sherpa-onnx** | **Apache-2.0** | `k2-fsa/sherpa-onnx` 的 `LICENSE`，2026-11-06 抓取确认 | 若用则链接 | ✅ 可用 |
| **whisper.cpp** | **MIT** | `ggerganov/whisper.cpp` 的 `LICENSE`，2026-11-06 抓取确认 | 若用则链接 | ✅ 可用 |
| **FunASR（Paraformer 运行时）** | **MIT** | `modelscope/FunASR` 的 `LICENSE`，2026-11-06 抓取确认 | 若用则链接 | ✅ 可用 |
| **SenseVoice（代码仓库）** | **MIT** | `FunAudioLLM/SenseVoice` 的 `LICENSE`，2026-11-06 抓取确认 | — | ✅ 代码可用（**权重另核，见 2.2**） |
| **VITS（代码仓库）** | **MIT** | `jaywalnut310/vits` 的 `LICENSE`，2026-11-06 抓取确认 | — | ✅ 代码可用（**权重另核，见 2.2**） |
| **piper（`rhasspy/piper`）** | **MIT**（代码） | `rhasspy/piper` 的 `LICENSE.md`，2026-11-06 抓取确认 | — | ⚠️ **代码 MIT，但不可用，见 2.3** |
| **piper（`OHF-Voice/piper1-gpl`，新仓库）** | **GPL-3.0**（仓库名即声明） | 抓取失败（返回空），但仓库命名与社区公告一致 | — | ❌ **禁止** |
| **espeak-ng** | **GPL-3.0** | `espeak-ng/espeak-ng` 的 `COPYING`，2026-11-06 抓取确认 | 若链接则整体传染 | ❌ **禁止链接**，仅可作独立 CLI |
| **ONNX Runtime** | MIT | 官方仓库长期声明，未逐版本抓取 | 若用则链接 | ✅ 可用（**需在锁版本时再核**） |
| **llama.cpp** | MIT | 官方仓库长期声明，未逐版本抓取 | 若用则链接 | ✅ 可用（**同上**） |

### 2.2 模型权重（**逐项核实状态**）

> 这一节是本轮最容易「看着开源、实际不能商用」的地方。规则：**核不到就标「未核实，禁止默认商用」，不得笼统写「开源」。**

| 权重 | 发布位置 | 许可状态 | 商用 | 备注 |
|---|---|---|---|---|
| OpenAI Whisper 官方权重（`tiny`/`base`/`small`） | openai/whisper（HF） | 仓库代码 MIT；**权重页许可字段需逐个确认** | **未核实 → 禁止默认商用** | 不同 size 的模型卡可能标注不同，不能一句「Whisper 是 MIT」带过 |
| whisper.cpp 的 GGML 量化权重（社区转换） | huggingface 上多个第三方仓库 | **各家不同，多为 MIT 或 Apache-2.0，但有例外** | **未核实 → 禁止默认商用** | 必须记录来源 URL 与 commit |
| SenseVoice-Small 权重 | ModelScope `iic/SenseVoiceSmall` | 代码仓库 MIT；**模型页许可字段未核实** | **未核实 → 禁止默认商用** | ModelScope 模型有自己的「模型许可协议」，与 GitHub LICENSE 是两回事 |
| Paraformer 中文权重 | ModelScope `iic/speech_paraformer*` | **未核实** | **未核实 → 禁止默认商用** | |
| VITS 中文权重（各类第三方训练） | 分散在 GitHub / HF / B 站分享 | **未核实，且训练数据来源常不明** | **高风险，默认禁止商用** | 中文 VITS 权重是许可最乱的一类 |
| sherpa-onnx 发布的预训练模型包 | `k2-fsa/sherpa-onnx` releases / HF | **每个模型包自带 LICENSE，需逐包打开确认** | **逐个核实后决定** | 同一个 releases 页面里可能混着 Apache-2.0 与 CC-BY-NC 的模型 |
| piper voices（`.onnx` 声线） | HF `rhasspy/piper-voices` | **每个 voice 有各自 license（常见 MIT / CC BY 4.0 / CC BY-NC）** | **逐个核实** | **NC 类不可商用**，这是最常见的踩坑点 |
| Qwen2.5 系列 | HF `Qwen/*` | **Apache-2.0**（长期声明） | ✅ 可用（需再核具体型号卡） | 但本项目 P0 走云端 API，权重不落地 |
| Llama 系列 | Meta | **Llama Community License，非 OSI 认可** | ⚠️ 有月活限制与命名要求 | 本项目不使用 |

**落地要求：**
1. `THIRD-PARTY.md` 里每个权重必须记录：`名称 / 来源 URL / 抓取日期 / 许可文件快照 / 是否可商用`；
2. 商用版本只允许打包「已核实为 MIT / Apache-2.0 / BSD / CC-BY（非 NC）」的权重；
3. **P0（DIY 自用）阶段不涉及商用，可先用未核实权重验证链路，但必须在文档里写明「自用验证，不得对外分发」**。

### 2.3 「看着宽松、实际带毒」的核心案例：piper

**事实链：**
- `rhasspy/piper` 的代码仓库 LICENSE = **MIT**（已抓取确认）；
- 但 piper 的文本前端依赖 **`piper-phonemize`**，后者链接 **espeak-ng**；
- `espeak-ng` 的 `COPYING` = **GPL-3.0**（已抓取确认）；
- GPL-3.0 的传染性在于「链接成同一程序」→ **把 piper + espeak-ng 链进 AD 核心，AD 核心整体就必须以 GPL-3.0 发布**；
- 更直接的证据：piper 项目已迁移到新仓库 **`OHF-Voice/piper1-gpl`**，**仓库名里的 `gpl` 就是作者对许可证现状的明示**。

**结论：piper 全线禁用。** 替代：**sherpa-onnx TTS（Apache-2.0）** 或云端 TTS。

**唯一合法的用法（本项目不用，但写清楚边界）：**
- 把 piper 编译成**独立可执行文件**，AD 核心通过 `std::process::Command` 调它，用 stdin/stdout 传文本与 WAV；
- 此时 AD 核心与 piper 是两个程序，通过文件/管道通信，**不构成衍生作品**；
- 但分发时必须一并提供 piper 的源码与 GPL-3.0 文本，且用户必须能替换该二进制（GPL-3 的 anti-tivoization 条款）；
- **代价**：多一个进程、多 30–60 MB 内存、BBB 上根本跑不动 → 工程上不划算，所以不用。

---

## 3. 音频库

| 组件 | 许可证 | 链接进核心 | 隔离方式 | 风险 |
|---|---|---|---|---|
| **ALSA lib**（`libasound2`） | **LGPL-2.1** | 动态链接 | LGPL 允许动态链接而不传染，但需**允许用户替换该 .so** 且提供其源码获取方式 | 低-中 |
| **PulseAudio** | LGPL-2.1 | 否（独立守护进程） | 通过 socket 通信 | 低 |
| **PipeWire** | **MIT** | 否（独立守护进程） | 通过 socket 通信 | 低 |
| **libopus** | BSD-3 | 静态链接 | 保留声明 | 低 |
| **libsoxr**（若要高质量重采样） | LGPL-2.1 | 动态链接 | 同 ALSA | 低-中 |
| **WebRTC Audio Processing（AEC3）** | BSD-3 | 静态链接 | 保留声明 | 低 |
| **FFmpeg** | 默认 **LGPL-2.1+**；`--enable-gpl` 则 **GPL-2.0+** | **不链接** | 仅作独立 CLI 调用（如批量转码），且**必须是 LGPL 构建**，不能用带 `--enable-gpl` 的发行版二进制 | **中-高** |
| PAM8403 / 喇叭 / 驻极体麦 | 硬件，不涉及软件许可 | — | — | — |

**FFmpeg 的坑（必须写清）：**
- 「FFmpeg 是 LGPL」这句话只在**默认构建**下成立；
- 一旦启用 `--enable-gpl`（为了 x264 等），整体变 **GPL-2.0+**；
- 很多 Linux 发行版自带的是 GPL 构建；
- **本项目不链接 FFmpeg**，音频编解码只用 libopus（BSD-3）与平台自带解码器（Android `MediaCodec` / Linux `libmpg123` 视需要）。

---

## 4. UI 框架

| 框架 | 许可证 | 体积 | 依赖 | 结论 |
|---|---|---|---|---|
| **egui / eframe** | **MIT OR Apache-2.0** | ≈ 5–8 MB | 无 WebView | ✅ **采用** |
| Tauri 2.x | MIT OR Apache-2.0 | 8–15 MB | **WebView2（Win）/ WebKitGTK（Linux）** | ⚠️ 备选，破坏兼容基线 |
| Slint | **GPL-3.0 或商业授权** | 6–10 MB | 无 | ❌ **禁用于本项目**（违反 D5） |
| iced | MIT | 6–9 MB | 无 | ✅ 可用（备选 2） |
| GTK4（gtk-rs） | **LGPL-2.1+** | 依赖系统库 | 系统 GTK | ⚠️ 动态链接可行，但 Rocky 8 的 GTK 版本偏旧 |
| Qt（PySide / qt-rs） | **LGPL-3.0 / GPL / 商业** | 大 | 重 | ⚠️ 不用 |
| Kotlin + Jetpack Compose | **Apache-2.0** | — | Android 平台 | ✅ 采用 |
| Flutter | **BSD-3** | 大（引擎 ~20 MB） | — | ⚠️ 可用但不用（见周计划 §1） |

---

## 5. 打包与构建工具（工具不传染，但要记录）

| 工具 | 许可证 | 是否影响产出物许可 | 说明 |
|---|---|---|---|
| Cargo / rustc | MIT OR Apache-2.0 | 否 | |
| `cargo-ndk` | MIT OR Apache-2.0 | 否 | |
| Gradle | Apache-2.0 | 否 | |
| Android SDK / NDK | Android SDK License（专有） | 否（但限制 SDK 本身的再分发） | 不把 SDK 打进仓库 |
| **KiCad** | **GPL-3.0** | **否** | **工具输出（.kicad_sch / .kicad_pcb / Gerber）不构成衍生作品**，可用任意许可发布；我们主动选 CERN-OHL-S-2.0 |
| **FreeCAD** | **LGPL-2.1+** | 否 | 同上；`.FCStd` 文件自身不含 FreeCAD 代码 |
| **OpenSCAD** | **GPL-2.0+** | 否 | 同上；`.scad` 是我们自己写的代码，我们选 CERN-OHL-S 发布 |
| Inkscape | GPL-2.0+ | 否 | 出图用 |
| 7-Zip / zip | LGPL / 公有领域 | 否 | |

**一句话：构建工具即使是 GPL，只要不把它的代码链接进我们的产物，就不传染。** 这条边界要守住，也要在文档里讲明白，避免以后有人拿「KiCad 是 GPL」来质疑硬件许可。

---

## 6. Android 端第三方 SDK

| SDK | 许可证 | 结论 |
|---|---|---|
| AndroidX（core / activity / lifecycle 等） | Apache-2.0 | ✅ |
| Jetpack Compose（BOM） | Apache-2.0 | ✅ |
| `androidx.security:security-crypto` | Apache-2.0 | ✅ |
| Kotlin stdlib / coroutines | Apache-2.0 | ✅ |
| Google Play Services（**不引入**） | 闭源 | ❌ 不引入，避免 APK 体积与隐私面 |
| 各云厂商语音 SDK（**不引入**） | 闭源 | ❌ 一律走 HTTPS，不引 SDK |
| Firebase Crashlytics（**不引入**） | 闭源 | ❌ |

**红线：APK 内不出现任何闭源二进制 SDK。** 云服务只走 HTTP/WebSocket 协议调用，这样也便于切换到国产或自建服务。

---

## 7. 硬件与系统侧

| 项 | 许可证 | 说明 |
|---|---|---|
| BeagleBone Black 板级设计 | **OSHW / 开源（BeagleBoard.org 官方仓库）** | 满足 L1；再分发时保留其声明 |
| Debian（BBB 系统） | 各组件混合（GPL/LGPL/MIT/BSD） | **作为操作系统发行版**，与 AD 核心是「聚合」关系，不传染；但**不得修改其 GPL 组件后闭源分发** |
| Linux 内核 | GPL-2.0 | 内核模块若自研则需 GPL；本项目**不写内核模块**（用现成 usbhid / uinput） |
| systemd | LGPL-2.1+ | 独立进程 |
| BlueZ（蓝牙，若用） | **GPL-2.0** | 若只调用 D-Bus 接口 → 合法；**若链接 `libbluetooth` → 传染**。本项目 P0 不用蓝牙 |
| ALSA 用户态工具（`aplay`/`arecord`） | GPL-2.0 | 独立 CLI 调用，合法；但我们用 `cpal`，不依赖这些 CLI |

---

## 8. 风险汇总（按严重度）

| 等级 | 条目 | 处置 |
|---|---|---|
| **禁止** | piper + espeak-ng 链接、Slint、`OHF-Voice/piper1-gpl`、带 `--enable-gpl` 的 FFmpeg | 一律不用 |
| **高** | 中文 VITS 权重、来源不明权重、CC-BY-NC 声线 | 商用前必须逐个核实；核不到就不用 |
| **中** | SenseVoice / Paraformer / Whisper 权重（代码 MIT，权重另议）；`ring` 例外条款；LGPL 动态链接（ALSA/libsoxr） | 记录来源、锁定 commit、THIRD-PARTY 逐条列出 |
| **低** | 其余宽松依赖 | 保留声明即可 |

---

## 9. 每个依赖落地时的动作清单

1. 锁定精确版本（`Cargo.lock` / Gradle 版本目录 / 模型 commit hash）；
2. 抓取该版本的 `LICENSE` 原文存到 `docs/licenses/<组件名>.txt`；
3. 在 `THIRD-PARTY.md` 追加一行：组件 / 版本 / 许可 / 用途 / 是否修改过；
4. 若为 LGPL 动态链接：确保用户可替换 `.so`，并在文档给出替换方法；
5. 若为模型权重：记录发布页 URL 与许可字段截图，标注「可商用 / 不可商用 / 未核实」。
