xubicheng/advanced-desktop/hardware/adapter-board/AD-Carrier-Lite-v0.1.step

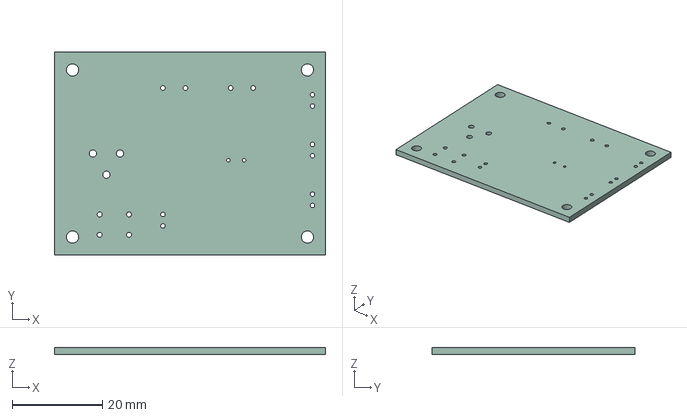
[picture p3: CAD file, 2026-11-10]
hardware/adapter-board/AD-Carrier-Lite-v0.1.step
60.0 x 45.0 x 1.60 mm
