xubicheng/advanced-desktop/docs/CHANGELOG.md

# CHANGELOG

## v4.0 — 2026-11-06（概念模型修正：AD ≠ 桌面软件）

> **一句话：把「AD 要做三个平台版本」改成「AD 只有一个本体，屏幕是可选外设」。**
> 这是本版唯一的概念变更，但它推翻了 v3 的整个软件架构章节。

### 4.1 为什么改（用户澄清）

v3 把 D4 理解成「AD 要做 Android 版 + Windows 桌面版 + Linux 桌面版」三套软件，并据此选了 egui 做桌面壳。

用户澄清后，正确理解是：

> **AD 是那台无屏计算机，显示器是别人的。** AD 的画面要能输出到 Windows 10/11 的显示器上、也要能输出到 Linux（Ubuntu 系、CentOS 系）的显示器上。手机（Android）只是 AD 的其中一种**载体**，手机自己的屏幕可以息屏。

这个差别不是措辞问题：**它把「Windows/Linux 端」从「AD 的另一个版本」降级为「一台显示器 + 一只被遥控的鼠标」**，工程量、许可面、体积、维护成本全部改变。

### 4.2 改了什么

| # | 变更点 | v3 | v4 | 影响章节 |
|---|---|---|---|---|
| 1 | **概念模型** | 三族平台 + 一套核心多端外壳（三个完整 UI） | **AD 本体（计算+语音+指针）+ 可选屏幕**；两个渲染器 + 一个 Receiver | v4 §1，取代 v3 §5.1 |
| 2 | **桌面端定位** | 「Windows/Linux 桌面壳 = AD 的一个客户端」 | **Receiver = 外设**：只显示帧、只注入指针，不含 AD 逻辑 | v4 §2、§3 |
| 3 | **UI 共享的表述** | 「同一套 UI」/「一套核心 + 多端外壳」（含糊） | **共享 UI 状态模型 + 版式 token + 文案；渲染器是两个（Android Canvas / BBB egui）；像素不共享** | v4 §3.3 |
| 4 | **桌面技术栈** | egui / eframe（需要 OpenGL 3.3 或 DX12） | **winit + softbuffer（纯 CPU 位图 blit，零 GPU 要求）** | v4 §6.1 |
| 5 | **体积目标** | 未定义 | **Win 单 exe ≤4 MB；Linux AppImage ≤12 MB** | v4 §6.1 |
| 6 | **新增：投屏三方案取舍** | 无 | 自渲染 + 自有 Receiver（MJPEG/TCP）/ scrcpy 路线 / WebRTC-H.264，逐维度对比并定首选项 | v4 §2 |
| 7 | **新增：帧传输设计** | 无 | TCP 单连接双向（帧下行 / 事件上行）、8 字节帧头、状态驱动发帧（静态零带宽） | v4 §2.4、§3.1 |
| 8 | **新增：反向输入链路** | 只有 BBB 自己的光标 | OTG HID → `PointerEvent` → Receiver → `SendInput` / `/dev/uinput`；并与 BBB 端共用事件抽象 | v4 §4 |
| 9 | **新增：息屏实测计划** | 只有「息屏可用」的原则 | T1–T6 六条可执行测试 + 三厂商 ROM | v4 §5.3 |
| 10 | **兼容基线收窄并写死** | Win10 1809+ / glibc ≥2.28（已写） | 沿用，并**明确 Receiver 的分发形态与不支持的发行版**（CentOS 7/8 明确不支持） | v4 §6 |
| 11 | **两周计划扩展为四周** | W1–W2 语音，W3–W4 桌面壳 | W1–W2 语音（UI 改为渲染到 Bitmap）；**W3 投屏打通；W4 反向指针 + 息屏实测** | v4 §8 |
| 12 | **能力差异表写死** | 分散在正文 | BBB 与 Android 载体逐项对照（分辨率 / 本地模型 / 直出 HDMI / 功耗 / 延迟） | v4 §7.2 |
| 13 | **新增风险 7 条** | 无 | 编码帧率、ROM 限流、uinput 权限、UAC 边界、USB 授权弹窗、UI 漂移、认知偏差 | v4 §9 |

### 4.3 技术纠偏（对用户描述的修正，必须记）

| 用户描述 | 我的判断 | 处理 |
|---|---|---|
| 「MVP 建议 MJPEG over TCP，Android 自带 `YuvImage`/JPEG 编码」 | **方向正确，API 选错**。`YuvImage` 吃 NV21/YUV420，是给相机预览用的；我们自渲染的产物本来就在 `Bitmap` 里（ARGB_8888），应该用 `Bitmap.compress(JPEG, q, out)`，一行搞定，无需 YUV 转换 | 采纳「MJPEG over TCP」，改用 `Bitmap.compress`；q 取 72–80 |
| 「方案 1 优点：可完全息屏（不依赖 MediaProjection 抓屏）」 | **判断正确且是关键优势**。自渲染与屏幕是否点亮无关 | 作为首选方案的核心理由 |
| 「方案 2 scrcpy 兜底」 | 同意做兜底，但要说清它的两个硬伤：**镜像的是整块手机屏**（含状态栏/通知），以及**每次连接要授权 USB 调试** | 列为兜底，触发条件写死 |
| 「方案 3 WebRTC/H.264」 | 同意「功能强但许可与体积是大问题」；补充：**H.264 的 MPEG-LA 专利池**在自用场景无碍，分发场景需评估 | 列为将来升级路径，给出 4 个切换点 |

### 4.4 未变的部分（避免误解为全盘重做）

| 项 | 状态 |
|---|---|
| D1 β = BeagleBone Black | **不变** |
| D2 真鼠标形态 132×76×40mm | **不变** |
| D3 内嵌成品 USB 鼠标模块（不自研 PMW3389） | **不变** |
| D5 严格宽松许可（不 link GPL；GPL 仅作独立进程） | **不变**，且 Receiver 全栈 MIT/Apache，比 v3 更干净 |
| 散热（ABS / 侧进底出 / 3.3–3.6% 开孔率 / 锁频 800MHz / ≤45°C） | **不变** |
| 供电（DC 5V/4A、20AWG、入口 ≥4.90V） | **不变** |
| BBB 的 L1 降级链 T0–T4 | **不变** |
| 本地 STT/TTS 判死 | **不变**（BBB 与 Android 都不做本地识别） |
| 淘宝采购清单、线下通用件清单、总预算 | **不变**（Receiver 是纯软件，不增加 BOM） |
| 720p UI 规范（正文 ≥24px、按钮 ≥64px、单列三栏、禁双栏） | **不变**，且现在同时适用于 HDMI 直出与投屏两条路 |
| 参考资料对照（豆包 `AD设计方案_v2.md`） | **不变**，见 v3.0 §3.2 |

### 4.5 被本次推翻、不得再引用的表述

| 表述 | 状态 |
|---|---|
| 「AD 要做 Android / Windows / Linux 三套软件」 | ❌ 已推翻 |
| 「Windows/Linux 桌面壳用 egui 写完整的 AD 界面」 | ❌ 已推翻（改为 Receiver） |
| 「一套核心 + 多端外壳 = 三端各有一个完整 UI」 | ❌ 已推翻（两个渲染器 + 一个接收器） |
| 桌面端依赖 WebView2 / WebKitGTK / OpenGL 3.3 / DX12 | ❌ 已消除（softbuffer 纯 CPU） |

### 4.6 新增文档

| 文件 | 内容 |
|---|---|
| `docs/v4/AD-鼠标形无屏微型计算机-设计方案-v4.md` | 概念模型修正、投屏三方案取舍、Mermaid 数据流（路 A / 路 B）、反向输入、息屏实测计划、兼容基线、能力差异表、新增风险 7 条 |

---

## v3.0 — 2026-11-06（β 路线定稿）

> 触发原因：用户拍板 D1–D5，要求 v3 方案 + Android 优先落地计划 + 淘宝优先采购清单，并把项目建公开仓库上云。
> 本版是 **v2 的收敛版**：不再给候选，只给一条路，并把这条路的代价算到底。

### 3.1 决策落定带来的变更

| # | 变更点 | 原因 | 影响 |
|---|---|---|---|
| 1 | **主控定为 β = BeagleBone Black（AM3358 单核 1GHz / 512MB / 4GB eMMC）**，BeaglePlay 从「首选」降为「降级链 T3」 | 用户 D1 拍板 β | 性能天花板从 4 核/2GB 降到单核/512MB；本地 AI 全部作废（见 #7） |
| 2 | **形态从掌托式 160×95×45 改回真鼠标 132×76×40** | 用户 D2 拍板「必须像鼠标」 | 散热面积减少 47%（0.081→0.043 m²）；重量 250–300g；握持改为掌心抓握 |
| 3 | **光学方案从「PMW3389 + 透镜 + 光学腔自研」改为「内嵌成品 USB 鼠标模块」** | 用户 D3 拍板 | 光学腔、安装公差、DPI 配置全部不再是我们的问题；改为「选型 + 光学高度适配」问题；删掉 v2 的 2 颗传感器 BOM |
| 4 | **输出分辨率由 1080p 降为 720p（1280×720）** | 单核显示子系统 + TDA19988 + 512MB 内存 | 新增 720p UI 规范（正文 ≥24px、按钮 ≥64px、禁双栏），见 v3 方案 §3.3 |
| 5 | **供电由 USB-C 5V/3A 改为 DC 5.5×2.1 barrel 5V/4A** | BBB 无 USB-C；micro-USB 供电实践上限 ~1A | 电流预算峰值 2.76A；线材 ≥20AWG ≤1m；验收线入口 ≥4.90V |
| 6 | **目标平台由「Linux + Android 双端」扩为「Android / Windows 10-11 / Linux 桌面」三族 + BBB 硬件端** | 用户 D4 澄清：「兼容 Windows10 以上 + Linux（Ubuntu/CentOS 系）」 | 兼容基线写死：Win10 1809+、glibc ≥2.28；**明确不支持 CentOS 7/8**（已 EOL）；不做 macOS/iOS |
| 7 | **本地 STT/TTS 判定不可用，默认云端，本地只留 6–10 条预录提示音 + 规则引擎** | 单核 Cortex-A8 实测预期：whisper tiny 慢 5–10 倍、sherpa-onnx 慢 3–5 倍 | 离线能力从「能听」降为「只会说固定几句」；删除 v2 的「本地 STT 可选路径」 |
| 8 | **桌面 UI 框架定案 egui**（Tauri 备选、Slint 淘汰） | Slint 是 GPL-3.0 违反 D5；Tauri 依赖 WebView2/WebKitGTK 破坏 Win10 1809 与 Rocky 8 基线 | 桌面壳体积 ≈6MB、内存 ≈50MB；中文 IME 弱，主交互改语音 |
| 9 | **新增「六项工程连带代价」专章**（外壳尺寸、USB Hub、720p、单核性能、micro-HDMI+供电、L1 降级链） | 用户要求「逐条算清楚，别回避」 | 每条都给出具体数值与判定线，不再用「基本可行」这类模糊表述 |
| 10 | **新增 L1 降级链 T0–T4**（BBB → BBB Wireless → BeagleBone Green → BeaglePlay → AI-64 → 暂停） | 用户要求「BBB 停产/买不到的备选，不得退回专有板」 | 明确 T3 会同时推翻 720p 与「本地语音判死」两条结论，切换时必须重写章节 |
| 11 | **散热方案按鼠标尺寸重算**：材质 PETG→**ABS**、顶面不开孔、侧进底出、总开孔率 3.3–3.6%、锁频 800MHz | 壳体缩小后 PETG（Tg 75–80°C）会软化 | 新增「开孔率 vs 手感 vs 进灰」的量化权衡；后备 1 顶面格栅 / 后备 2 5V 风扇 |
| 12 | **保险丝由 1.1A 自恢复改为 3A 慢断** | 峰值 2.76A > 1.1A 保持电流，会误跳（v2 的疏漏） | 修正一个会导致「随机断电」的实际设计错误 |
| 13 | **采购改为淘宝优先**，线下只买通用件 | 用户指示 | 新表 A（关键路径 / 可延后）+ 表 B（金盛/华龙摊位类型）+ 总预算三档 |
| 14 | **新建公开仓库 `xubicheng/advanced-desktop`**，三许可分层（MIT / CERN-OHL-S-2.0 / CC-BY-4.0） | 用户要求上云 + 手机可看进度 | 新增 `.gitignore` 先于首次提交、`THIRD-PARTY.md`、`logs/` 脱敏纪要 |
| 15 | **新增 DECISIONS.md**（D1–D5 + C1 澄清 + O1–O6 未关闭项） | 决策需要可追溯 | 以后改方案必须先改 DECISIONS，再改设计 |
| 16 | **新增 Android 先行 2 周周计划**（含 7 条 W1 验收、8 条 W2 验收） | 用户 D4 要求 | 明确「每周 10–15 小时」的工时口径 |
| 17 | **新增许可清单表**（组件 / 版本 / 许可证 / 是否链接 / GPL 隔离 / 风险） | 用户 D5 要求 | 本轮实地抓取 6 个仓库 LICENSE 原文核实 |

### 3.2 参考资料对照：`D:\原有的下载2026.2\AD设计方案_v2.md`（豆包生成）

用户要求直接指出错误，不因为是「参考资料」就照收。以下为逐条判断。

#### A. 被采纳的点（4 条）

| # | 参考材料的观点 | 采纳理由 | 在 v3 中的落点 |
|---|---|---|---|
| A1 | 「一套共享核心 + 两个薄适配层」的架构 | 判断正确，且与用户 D4 一致 | v3 §5.1、§5.2；周计划 §2 |
| A2 | M0 用旧安卓手机 + Termux/Python 做零成本先验验证 | 成本最低的先验手段，能提前暴露 STT/TTS/延迟问题 | 演化为「Android 先行 2 周」，但改用 Kotlin 原生壳而非 Termux（见冲突 C2） |
| A3 | Android 14 前台服务 microphone 类型 + 通知 + 录音权限的机制描述 | 基本准确，与官方文档一致 | 周计划 §6 坑 1；v3 §5.4 |
| A4 | 手机可扮演「独立 / 伴侣 / 亮屏」三种角色 | 产品视角有价值，未来可扩展 | 列为后续可选形态，P0 不做 |

#### B. 与我的方案冲突的点，及取舍理由（5 条）

| # | 参考材料的观点 | 我的方案 | 取舍理由 |
|---|---|---|---|
| B1 | 硬件选 **Orange Pi Zero 2W**（¥130，30×65mm） | **BBB** | 硬门槛冲突：Zero 2W 的 H618 板级不开源（只有原理图 PDF，无 Gerber/可编辑源，datasheet 需 NDA），不满足 L1。**这是用户已明确的硬约束，不是性能之争** |
| B2 | 核心用 **Go（BSD-3）+ gomobile 出 .aar** | **Rust（MIT）+ cdylib + 手写 JNI** | ① AAR 体积 10–20MB vs Rust ≈2–4MB；② gomobile 的 JNI 调用开销对逐帧音频不友好；③ Go GC 停顿会打断流式 TTS；④ Rust 能同一份代码编到 armv7（BBB），Go 交叉编译到 ARMv7 硬浮点需额外处理。**不是 Go 不好，是这个场景 Rust 更合适** |
| B3 | **Piper 列为「MIT，可商用」** | **Piper 全线禁用** | **这是参考材料的硬性事实错误**：`rhasspy/piper` 代码确实是 MIT（我 2026-11-06 抓取确认），但它依赖 `piper-phonemize` → 链接 `espeak-ng` → **GPL-3.0**（已抓取 `COPYING` 确认）。代码 MIT 不等于产物 MIT。且 piper 已迁到 `OHF-Voice/piper1-gpl`，仓库名直接写了 GPL |
| B4 | 用 **configfs HID gadget** 让设备模拟鼠标 | **内嵌成品 USB 鼠标模块** | 语义错误：HID gadget 是让 AD 变成「另一台电脑的鼠标」，而 AD 本身是要有光标的**主机**。方向反了。D3 用成品模块正好绕开 |
| B5 | 保留 **锂电池 + TP4056** 充电 | **已取消电池，DC 5V 直供** | 用户在 v2 阶段已明确取消电池（运输合规 + 安全 + 成本），参考材料未跟上 |

#### C. 明显错误 / 严重低估（5 条）

| # | 参考材料的说法 | 问题 | 我的修正 |
|---|---|---|---|
| C1 | 「每周投入 1–2 小时，9–14 周完成」 | **自相矛盾且严重低估**：它自己把「M5 安卓 App」排 4–6 周，按每周 1–2 小时算只有 6–12 小时——一个带前台服务、录音、播放、网络、UI 的 Android App 不可能在 12 小时内做完。真实工时约 **80–150 小时** | 周计划明确写「每周 10–15 小时」，2 周 ≈ 20–30 小时只做**最小链路**，不含产品化 |
| C2 | 「PMW3610 光学模块 20 元」 | 存疑：DIY 散件市场里「裸传感器 + 配套透镜」稀缺，20 元多为拆机件或需自配透镜，**未询价** | 不再采用自研光学（D3 已改为成品模块），此条自然失效；但记录为「参考材料的价格断言不可信」 |
| C3 | 「INMP441 + MAX98357 I2S 直连」 | 未验证 Zero 2W 是否把可用 I2S 引出到排针；即便引出，INMP441 是数字麦需 I2S 主时钟，MAX98357 也吃 I2S，两路共用需分时或双 I2S | 本项目改走 **USB 声卡**，零焊接、免驱、两端通用 |
| C4 | 「应用层全部宽松许可」 | 过于笼统，**遗漏了最容易出问题的两类：模型权重、FFmpeg 的 GPL 构建** | 许可清单把「代码许可」与「权重许可」分开列，权重逐项标注「已核实 / 未核实 → 禁止默认商用」 |
| C5 | 「Linux 音频 ALSA + PipeWire，许可证 LGPL/MIT」 | 表述含混：**PipeWire 是 MIT，ALSA lib 是 LGPL-2.1**，两者不是一回事，且 LGPL 的合规义务（可替换 .so）与 MIT 完全不同 | 许可清单 §3 分开列，并写明 LGPL 动态链接的合规动作 |

#### D. 我方自我纠正（1 条，必须记下来）

| # | 我曾经的判断 | 事实 | 处理 |
|---|---|---|---|
| D1 | 我在 v2 阶段曾怀疑「Orange Pi Zero 2W 没有 HDMI」，并准备把它列为参考材料的错误 | **错的是我**：Zero 2W 官方规格明确有 **Mini HDMI 2.0（4K60）** | 已在 v2 与本文中更正，**不把「无 HDMI」列为参考材料的错误点**。记录此条是为了留下「我也可能错」的证据链 |

### 3.3 本版新增的文档

| 文件 | 内容 |
|---|---|
| `docs/v3/AD-鼠标形无屏微型计算机-设计方案-v3.md` | v3 主方案：六项连带代价、架构、散热重算、V1–V14 验收、R1–R12 风险 |
| `docs/v3/Android-先行-周计划.md` | 2 周排期、W1/W2 共 15 条验收线、代码结构、三端兼容基线 |
| `docs/v3/许可清单.md` | 组件许可表（含实地抓取核实）、模型权重逐项状态、piper 案例、GPL 边界 |
| `docs/v3/采购清单-淘宝优先.md` | 表 A 淘宝（关键路径 / 可延后）、表 B 线下摊位、总预算三档 |
| `docs/DECISIONS.md` | D1–D5 + C1 平台澄清 + O1–O6 未关闭项 |

### 3.4 v2 中已被推翻、不得再引用的结论

| 结论 | 状态 |
|---|---|
| BeaglePlay 为首选主控 | ❌ 已推翻（降为 T3） |
| 形态为 160×95×45 掌托式 | ❌ 已推翻 |
| 自研 PMW3389 + 透镜 + 光学腔 | ❌ 已推翻 |
| 1080p 输出 | ❌ 已推翻（改 720p） |
| USB-C 5V/3A 供电 | ❌ 已推翻（改 DC 5V/4A） |
| 「本地 STT 作为可选路径」 | ❌ 已推翻（判死） |
| 「Tauri/egui/Slint 待定」 | ❌ 已定（egui） |
| BOM α/γ 两档 | ❌ 作废（只保留 β） |
| 1.1A 自恢复保险丝 | ❌ 修正为 3A 慢断 |

### 3.5 仍然有效（跨版本不变的判断）

| 项 | 说明 |
|---|---|
| 只用原生 HDMI，不做 MIPI→HDMI 桥接 | 不变 |
| 不做 USB HID 从设备（configfs gadget） | 不变，且被 D3 进一步印证 |
| 电视棒 / 树莓派 / H618 全部淘汰 | 不变 |
| Linux 内核是 GPL-2.0；不写内核模块 | 不变 |
| PTT 模式不需要 AEC（半双工） | 不变 |
| piper 禁用、Slint 禁用、FFmpeg 不链接 | 不变 |
| 手工组装友好：2.54 排针 / JST-XH / 禁 0.5mm FPC 与 BGA | 不变 |

---

## v2.0 — 2026-11-06（重大改版）

> 触发原因：用户明确「**全开源硬件是硬门槛**」，v1 的 H618/Orange Pi 路线因板级不开源而作废；同时新增「软件一套核心、Linux/Android 双端」要求，取消电池，并要求手工可组装。

### 变更记录（变更点 / 原因 / 影响）

| # | 变更点 | 原因 | 影响 |
|---|---|---|---|
| 1 | **主控由全志 H618（Orange Pi Zero 3）改为 BeaglePlay（TI AM6254）** | 用户要求板级全开源（原理图+PCB+Gerber+许可证），H618 仅有原理图 PDF、无 Gerber/可编辑源，且 datasheet 需 NDA | 成本 ¥320 → ¥1100；性能从"够用"变为"够用但壳变大"；合规层级从 L2 升到 L1 |
| 2 | 新增「开源硬件 L0–L3 四层判定」章节 | 用户要求把"开源硬件"分层讲清楚，这是方案能否站住的关键 | 明确结论：L0 在可买价位不存在；本产品天花板 = L1；避免"假开源"误导 |
| 3 | 新增 L1 候选核实表（BeaglePlay / BBB / BeagleV-Fire / Milk-V Mars / Jupiter / Lichee Pi 4A / HiFive / MangoPi） | 用户要求逐个附许可证、公开资料、是否含 Gerber、渠道价格、性能 | 结论：真正满足 L1 且能出图的只有 BeaglePlay 与 BBB；BeagleV-Fire 因无 HDMI 淘汰；Mars 仅原理图 PDF，判 L1.5 |
| 4 | 新增「三选二」硬取舍说明（L1 + 鼠标形态 + 1080p 三者只能取二） | BeaglePlay 尺寸 ≈89×70，装不进真鼠标壳；BBB 能装但只有 720p | 形态由"鼠标"改为"掌托式"（≈160×95×45）；必须由用户拍板接受或不接受 |
| 5 | 外壳尺寸 135×80×42 → **160×95×45**（α 路线） | 主板 89×70 + 喇叭腔 + 散热片装不下 | 握持方式改变（掌心搭放而非抓握）；重量 ≈400g |
| 6 | 新增 β（BeagleBone Black，720p 真鼠标）与 γ（Milk-V Mars，1080p 但不达 L1）两条备选路线 | 单一方案无法覆盖"形态优先/性价比优先"两种诉求 | 用户多两个选择；成本区间 ¥550 / ¥660 |
| 7 | **取消电池与充电模块，改为 USB-C 5V 供电** | 用户明确要求初代取消电池 | 去掉 IP5306/TP4056、锂电池与 UN38.3 风险；续航章节删除；新增电源保护与电流预算 |
| 8 | 新增电源保护设计（USBLC6-2SC6 ESD、PTC 3A 保险丝、470µF、磁珠、100nF） | 用户要求含 ESD/保险丝/滤波 | 新增元件 5 项；新增"供电不足判定"表 |
| 9 | 新增完整电流预算（典型 1.2A / 峰值 3.0A）与适配器要求 ≥5V/3A | 用户要求讲清 SoC + 喇叭峰值 | 明确禁止 5V/1A 充电器；新增 20AWG 线材要求 |
| 10 | 新增「外壳散热设计」章节（材质对比、开孔策略、铝底板混合、验收、两级后备） | 用户要求从外壳入手解决散热 | 材质从 PETG 单一选项改为"PETG + 1.5mm 铝底板"混合；新增开孔面积比（底 15%/侧 10%/后 12%/顶 ≤5%）；新增风扇后备 |
| 11 | 光学方案由"拆报废鼠标当主方案"改为"**买芯片+透镜配套件**"，拆鼠标降级为 P0 兜底 | 用户明确指示 | BOM 增加 ¥90（2 颗）；新增安装公差控制（2.0±0.1mm、限位台阶、垫片）；新增 P0/P1 熔断判据 |
| 12 | 新增「载板/底板开源设计约束」（2 层、≥0805、2.54 排针、禁 0.5mm FPC） | 用户要求手焊友好 | 底板元件数控制在 ≤25；明确"哪些自焊、哪些委外嘉立创 SMT" |
| 13 | 新增「许可证标注方式」（丝印 CERN-OHL-S / OSHW 使用规则） | 用户要求板上标注 | 明确自研板未认证不得直接印 OSHW 齿轮标；BeaglePlay 原标识不得磨除 |
| 14 | **软件架构从"单端"改为"一套 Rust 核心 + Linux/Android 双端薄壳"** | 用户新增手机端要求 | 新增 core/linux/android 三目录结构、C ABI 接口定义、配置项表、日志与隐私规则；复用率估算 70%（代码）/55%（工时） |
| 15 | 新增 Android 息屏可用方案（FGS microphone、通知、白名单、厂商 ROM 应对） | 用户要求手机端息屏可跑 | 新增 Android 14 权限清单、唤醒方式三选一取舍（选蓝牙/音量键，不选唤醒词）、5 家厂商设置路径 |
| 16 | **TTS 由 piper 改为 sherpa-onnx VITS** | **piper 依赖 espeak-ng（GPL-3.0），链接后整体变 GPL-3.0**，与"商用免费可闭源"冲突 | 授权风险消除；STT/TTS 统一到 sherpa-onnx（Apache-2.0），依赖从 2 个减到 1 个 |
| 17 | 新增完整许可证清单（宽松 / 弱 copyleft / 强 copyleft / 平台闭源 / 模型权重 五类） | 用户要求不得笼统说"都是 MIT" | 明确 FFmpeg LGPL/GPL 双轨、Kotlin/Compose Apache-2.0、Flutter BSD-3、UniFFI MPL-2.0、Qt 无关；列出 GPL 触发点 |
| 18 | 音频链路确定"两端统一走 USB 声卡（CM108）" | 手机与 Linux 都能免驱；I2S 在 BeaglePlay 上未引到 2.54 排针 | 一套音频硬件两端通用；I2S 方案推迟到 v3 载板 |
| 19 | 新增 BOM 三套（α/β/γ），含"关键路径"标注 | 用户要求两套 BOM 并标注采购地 | α ≈1269 元、β ≈500–560、γ ≈661 元 |
| 20 | 新增采购清单（线上/线下分列，含替代型号） | 用户要求线上淘宝/线下金盛华龙分开 | 明确"金盛/华龙买不到主板、传感器、声卡、Hub、高速 SD"这一现实边界 |
| 21 | 新增装配顺序表 S0–S10，每步含工时与可测量通过标准 | 用户要求"装配顺序 + 每步通过标准" | 总工时 ≈68h；新增 S1/S5 止损与熔断规则 |
| 22 | 新增走线/固定/绝缘规范与"上电前 5 步检查" | 用户要求走线固定绝缘建议 | 明确禁止热熔胶承重；新增限流上电流程 |
| 23 | 新增图纸交付清单（KiCad 8/9、FreeCAD 1.0、OpenSCAD、爆炸图、接线图） | 用户要求可交付图纸清单与关键尺寸约束 | 明确软件、格式、许可证；给底板 8 条开源设计约束、外壳 11 个参数变量 |
| 24 | 新增 v2 文档版本化管理：`docs/v1/`、`docs/v2/`、`docs/MVP-checklist/`、`CHANGELOG.md`、`README.md` | 用户要求整理每次修改并收录妥当 | v1 原文移动到 `docs/v1/` 保留不删；新增索引与变更记录 |
| 25 | 新增"飞书参考链接读取结果"附录 | 用户提供参考链接并要求如实说明 | 结论：返回登录页图片，**取不到**，未编造内容 |
| 26 | 验收项 T1–T20 扩充（新增 Android 息屏、隐私抓包、72h 长跑） | 覆盖双端与隐私要求 | 验收从 18 项扩到 20 项 |
| 27 | 新增 5 个待拍板决策点（原 4 个） | 新增 Android 优先级与许可证严格度 | D1 主控路线 / D2 形态 / D3 光学策略 / D4 开发顺序 / D5 许可严格度 |
| 28 | 风险表由 11 项扩到 12 项，新增"piper GPL-3.0"与"BeaglePlay 供货" | 改版引入的新风险 | R8 许可证风险、R12 供货风险 |

### 未变更（v1 仍然有效的判断）

| 项 | 说明 |
|---|---|
| 只用原生 HDMI，不做 MIPI→HDMI 桥接 | 结论不变（桥接需 QFN-64 手焊、1080p 上限、EDID 自调） |
| 光标走"传感器 → uinput → 合成器"，不做 USB HID 从设备 | 结论不变（语义歧义 + 硬件不支持） |
| 电视棒/盒子拆板淘汰 | 结论不变（L3 闭源 + 签名 + 供货灰色） |
| 树莓派淘汰 | 结论不变（用户排除 + 板级不开源） |
| Linux 内核是 GPL-2.0 不是 MIT；FreeBSD 不可行 | 结论不变 |
| PTT 模式不需要 AEC | 结论不变 |

### 待用户确认（阻塞项）

1. D1 主控路线 α/β/γ；
2. D2 是否接受 160×95×45 的掌托式形态；
3. D3 光学件策略（配套件自研 vs 内嵌鼠标模块）；
4. D4 先做 Android 还是先做 Linux 硬件端；
5. D5 许可证严格度（是否允许引入 GPL 组件）。

---

## v1.0 — 2026-11-06（初版，已归档）

- 主控：全志 H618 / Orange Pi Zero 3
- 音频：USB 声卡 CM108 + PAM8403
- 光标：PMW3389 + uinput
- 供电：5V/3A（含可选电池）
- 成本：稳妥版 ≈320 元 / 降本版 ≈169 元
- 归档位置：`docs/v1/AD-鼠标形无屏微型计算机-设计方案-v1.md`
- 作废原因：板级不开源，不满足用户"全开源硬件"硬门槛
