xubicheng/advanced-desktop/hardware/adapter-board/AD-Carrier-Lite-v0.1.kicad_pcb

## KiCad design hardware/adapter-board/AD-Carrier-Lite-v0.1.kicad_pcb (2026-11-10)

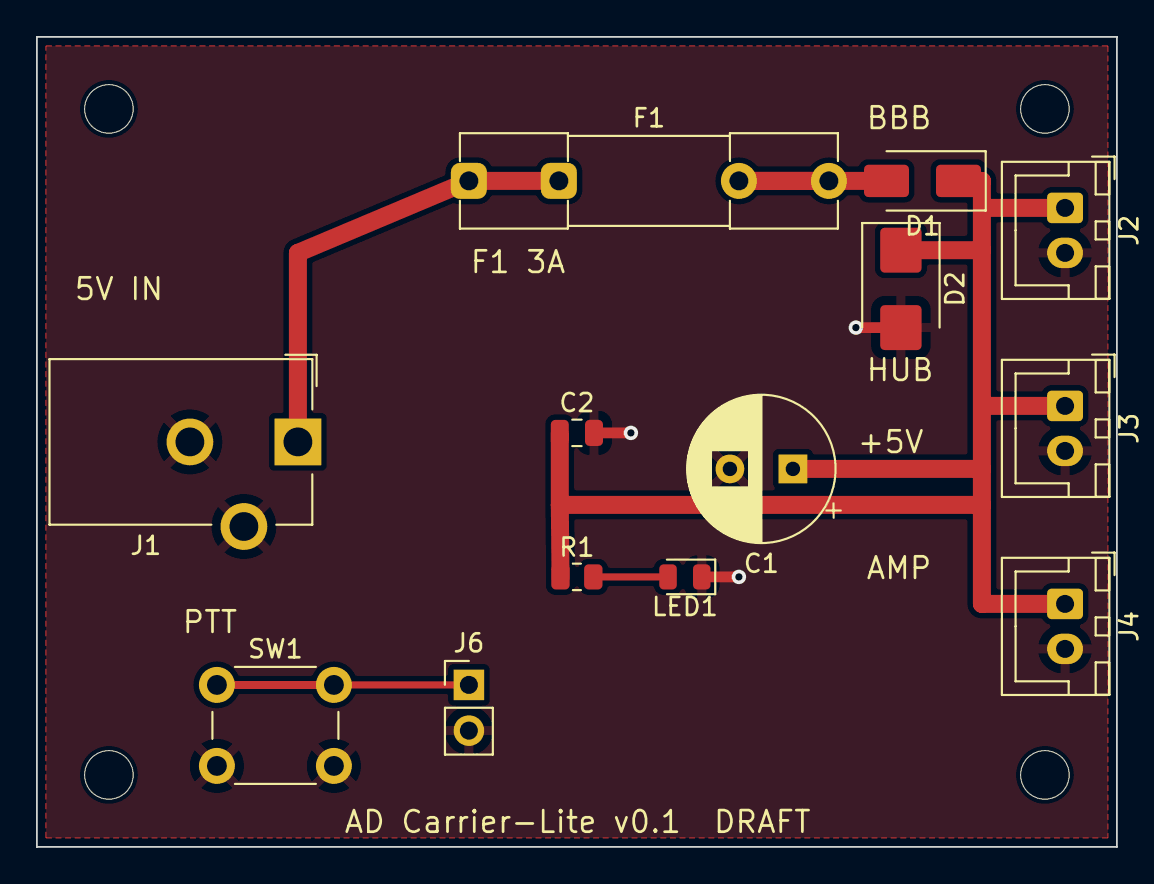
[picture p4: board AD-Carrier-Lite-v0.1.kicad_pcb from above]

Board: 2 copper layers, 60.0 x 45.0 mm, 17 parts (0 on the bottom side), 6 nets.

Parts:
C1: 470uF 10V; CP_Radial_D8.0mm_P3.50mm
C2: 100nF 50V; C_0805_2012Metric
D1: SS54; D_SMA
D2: SMAJ5.0A; D_SMB
F1: 3A slow-blow; Fuseholder_Clip-5x20mm_Littelfuse_111_Inline_P20.00x5.00mm_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
H1, H2, H3, H4: MountingHole_2.7mm_M2.5
J1: DC 5.5x2.1; BarrelJack_CUI_PJ-102AH_Horizontal
J2: 5V OUT BBB; JST_XH_B2B-XH-A_1x02_P2.50mm_Vertical
J3: 5V OUT HUB; JST_XH_B2B-XH-A_1x02_P2.50mm_Vertical
J4: 5V OUT AMP; JST_XH_B2B-XH-A_1x02_P2.50mm_Vertical
J6: PTT GPIO; PinHeader_1x02_P2.54mm_Vertical
LED1: Green; LED_0805_2012Metric
R1: 1k; R_0805_2012Metric
SW1: PTT; SW_PUSH_6mm

Connections:
5V_IN: F1.1, J1.1
+5V: C1.1, C2.1, D1.1, D2.1, J2.1, J3.1, J4.1, R1.1
FUSED: D1.2, F1.2
GND: C1.2, C2.2, D2.2, J1.2, J1.3, J2.2, J3.2, J4.2, J6.2, LED1.1, SW1.2
LED_A: LED1.2, R1.2
PTT: J6.1, SW1.1
