xubicheng/advanced-desktop/(commit log)

2026-11-05 docs: AD 方案 v1-v4 + 采购/许可/决策记录 + 仓库骨架
    - v1 H618 路线（已作废，存档）
    - v2 开源硬件 L0-L3 分层与候选核实（部分被 v3 取代）
    - v3 β 路线定稿：BBB + 720p + 成品 USB 鼠标模块 + DC 5V/4A，
    含六项工程连带代价、散热重算、V1-V14 验收、淘宝优先采购
    - v4 概念模型修正：AD 是本体、屏幕是可选外设；Windows/Linux 端
    改为 Receiver（显示帧 + 注入指针），投屏选 MJPEG over TCP
    - 三许可分层：代码 MIT / 硬件 CERN-OHL-S-2.0 / 文档 CC-BY-4.0
    - 首次提交前已加 .gitignore，并扫描排除密钥、令牌、邮箱、手机号、内网 IP
    [BOM-offline.csv, BOM-taobao.csv]
2026-11-10 feat: 整理AD项目对接资料
    [AD-电子元器件询价单-20261110.xlsx]
